texane/ooklone/doc/pic/scaled/0024.jpg

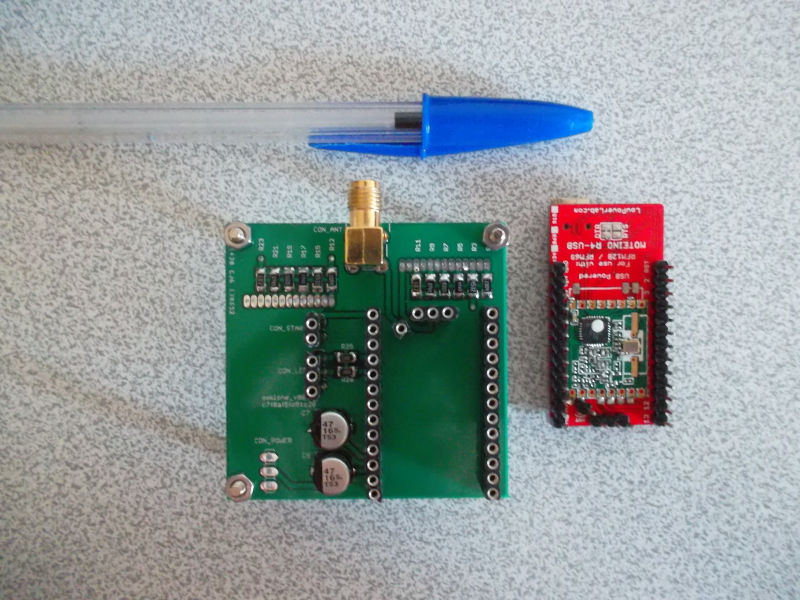
doc/pic/scaled/0024.jpg
