texane/ooklone/doc/pic/scaled/002f.jpg

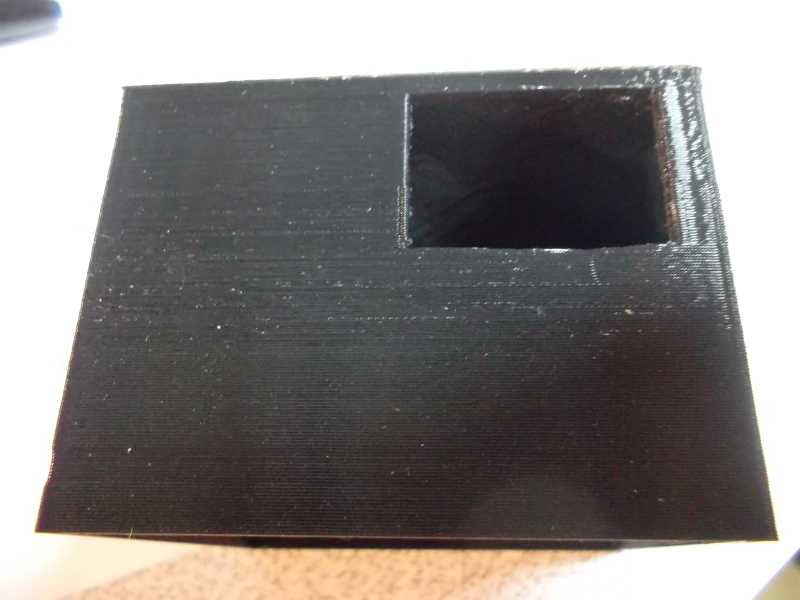
doc/pic/scaled/002f.jpg
