texane/ooklone/README

For more info, please read the article here:
http://www.embeddedrelated.com/showarticle/626.php
Also, this project was submitted to the Hackaday Prize Contest:
http://hackaday.io/project/2403-ooklone
