texane/ooklone/doc/pic/scaled/0000.jpg

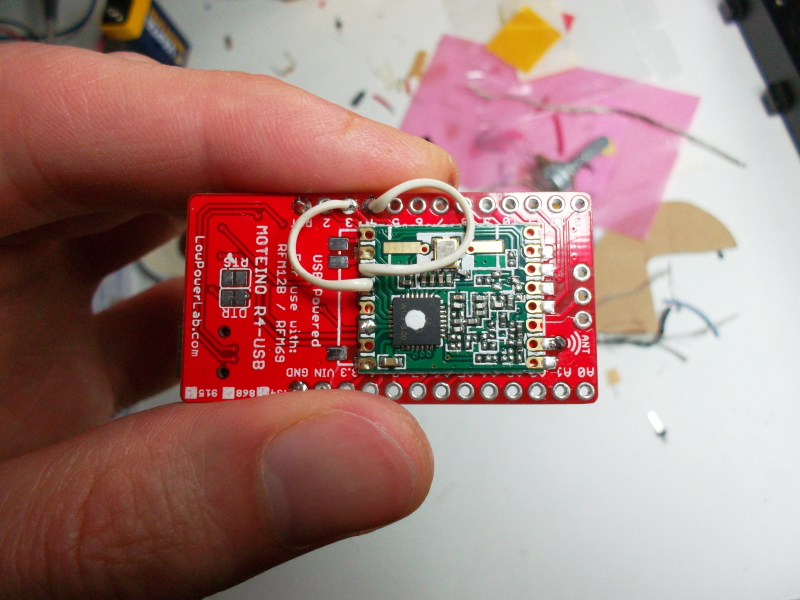
doc/pic/scaled/0000.jpg
