texane/ooklone/doc/pic/scaled/000a.jpg

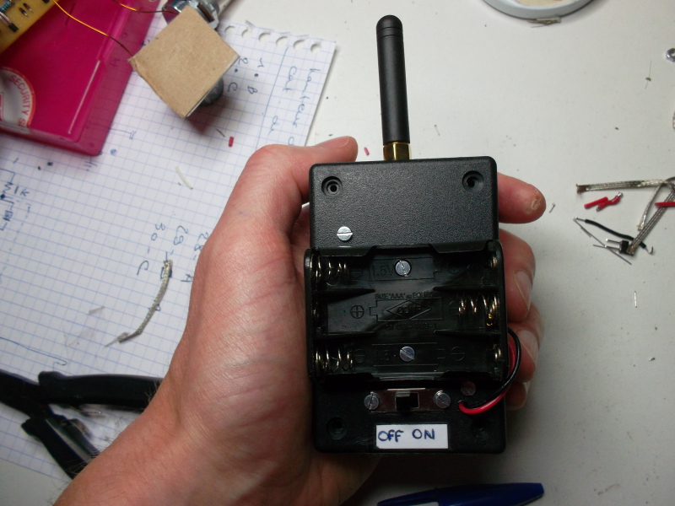
doc/pic/scaled/000a.jpg
