texane/ooklone/doc/pic/scaled/000b.jpg

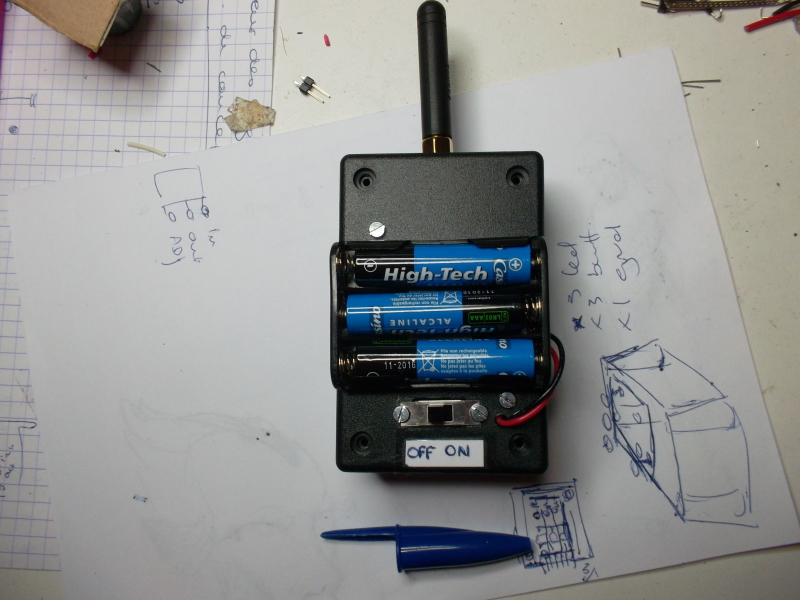
doc/pic/scaled/000b.jpg
