texane/ooklone/doc/pic/scaled/000c.jpg

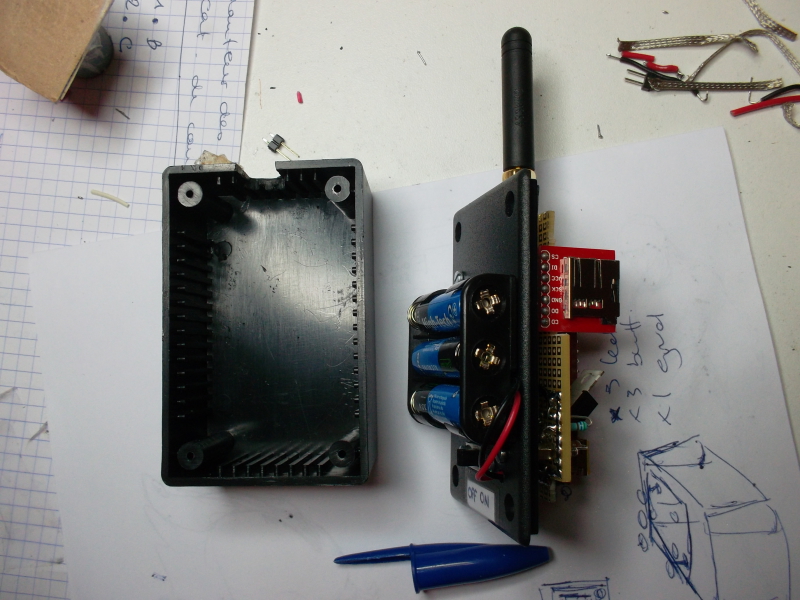
doc/pic/scaled/000c.jpg
