texane/ooklone/doc/pic/scaled/000d.jpg

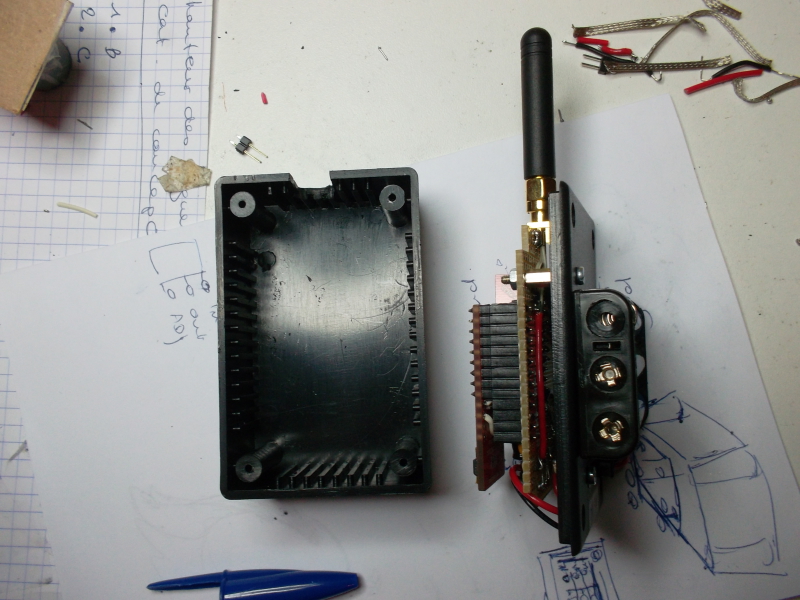
doc/pic/scaled/000d.jpg
