texane/ooklone/doc/pic/scaled/000e.jpg

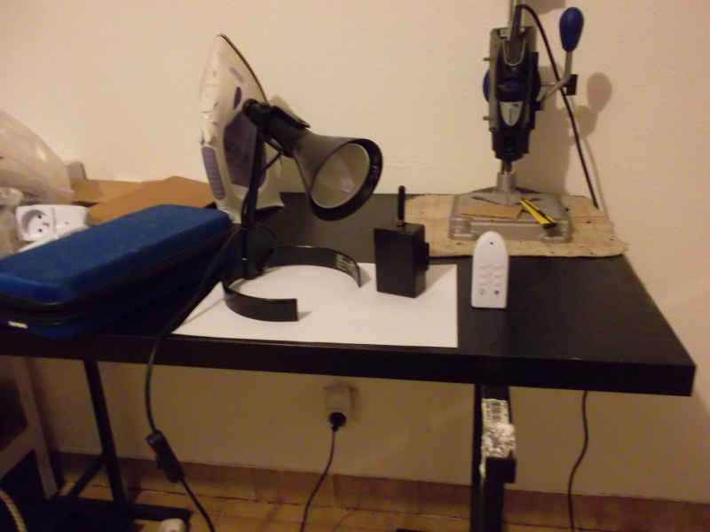
doc/pic/scaled/000e.jpg
