texane/ooklone/doc/pic/scaled/000f.jpg

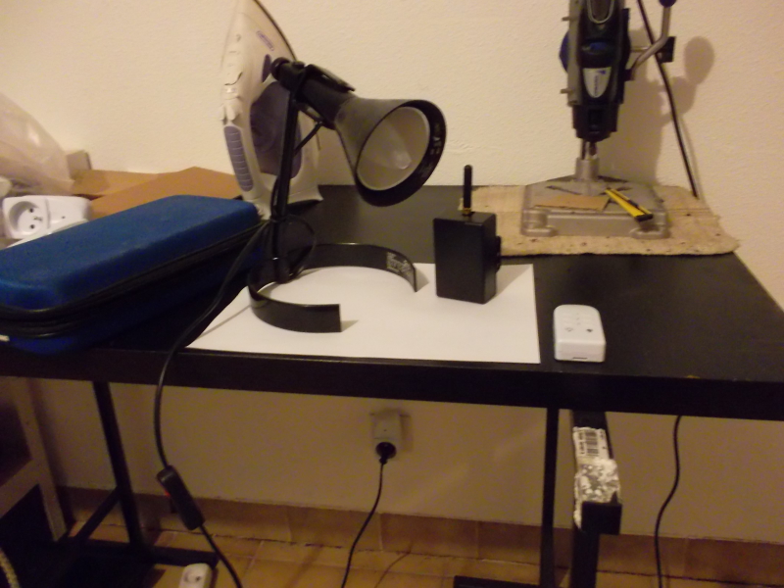
doc/pic/scaled/000f.jpg
