texane/ooklone/doc/pic/scaled/0001.jpg

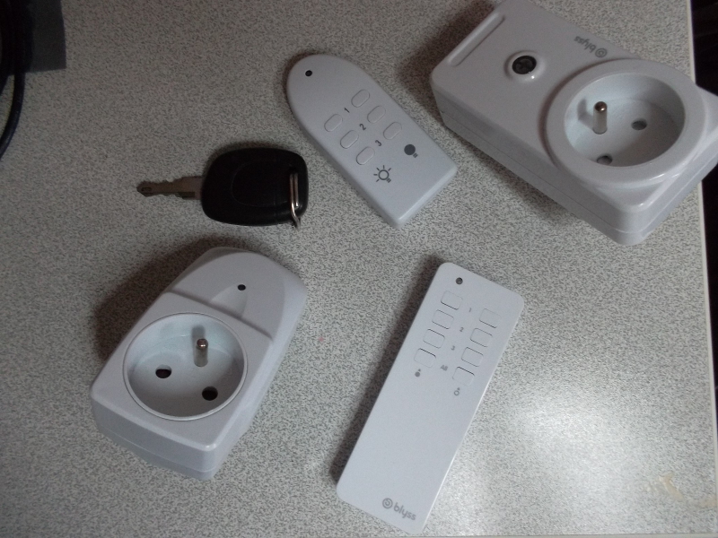
doc/pic/scaled/0001.jpg
