texane/ooklone/doc/pic/scaled/001a.jpg

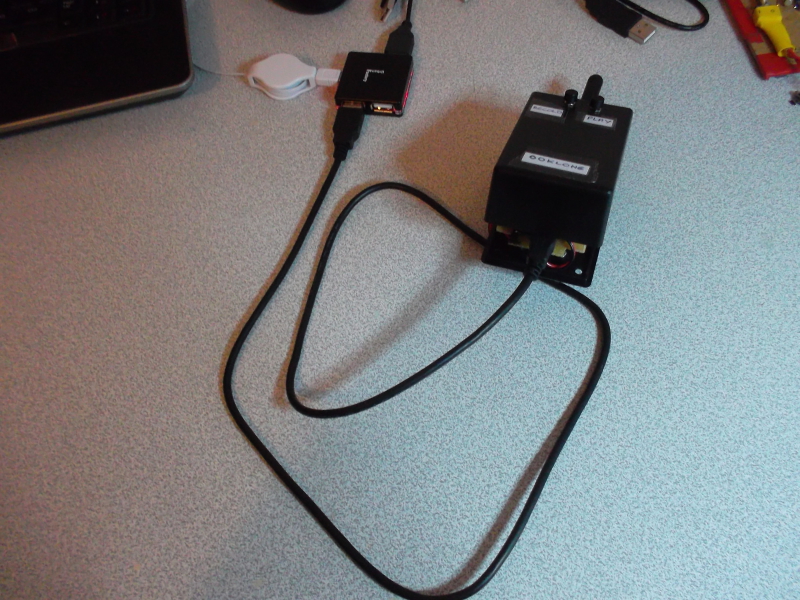
doc/pic/scaled/001a.jpg
