texane/ooklone/doc/pic/scaled/001b.jpg

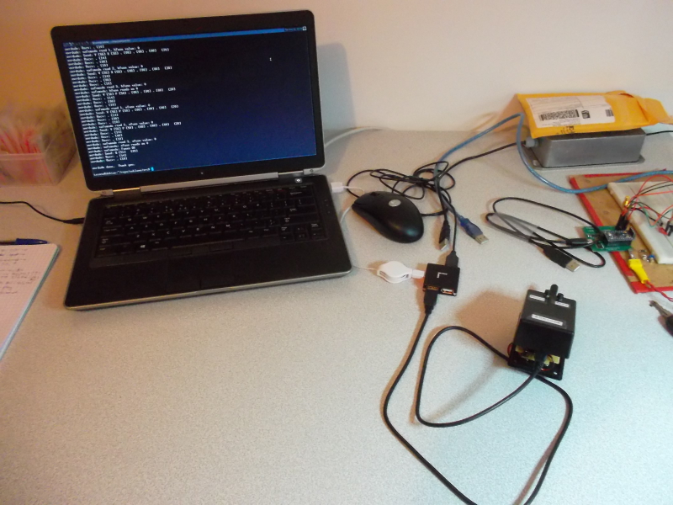
doc/pic/scaled/001b.jpg
