texane/ooklone/doc/pic/scaled/001c.jpg

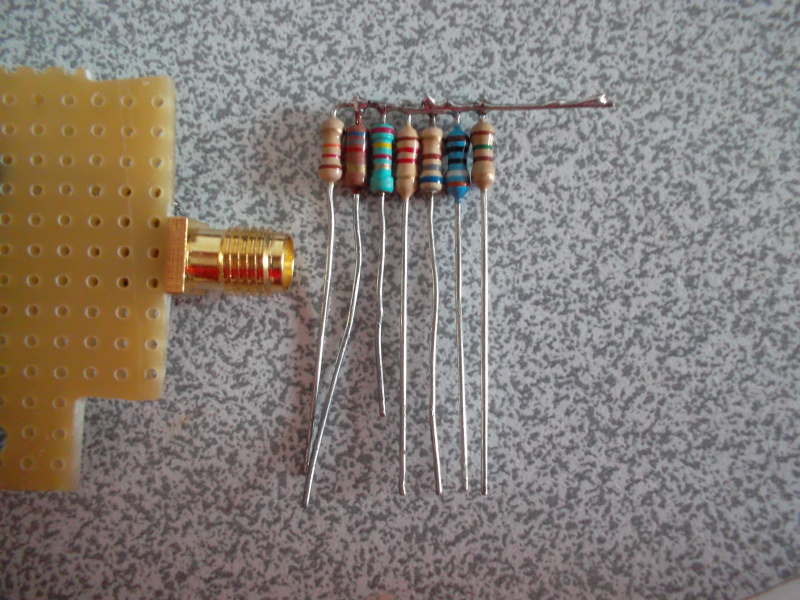
doc/pic/scaled/001c.jpg
