texane/ooklone/doc/pic/scaled/001d.jpg

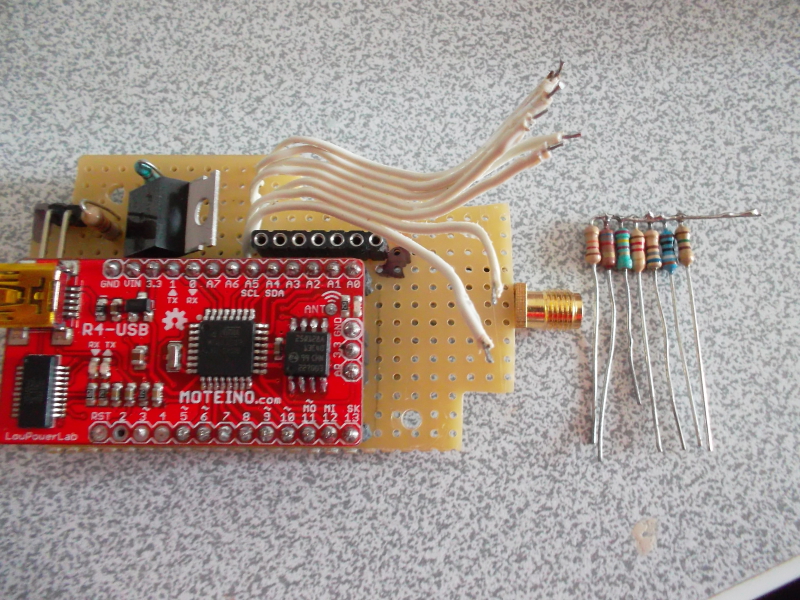
doc/pic/scaled/001d.jpg
