texane/ooklone/doc/pic/scaled/001e.jpg

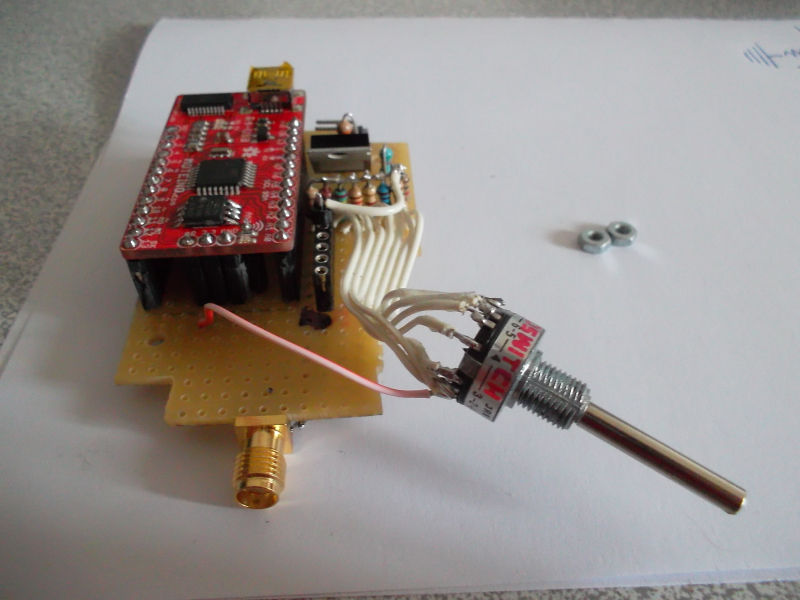
doc/pic/scaled/001e.jpg
