texane/ooklone/doc/pic/scaled/001f.jpg

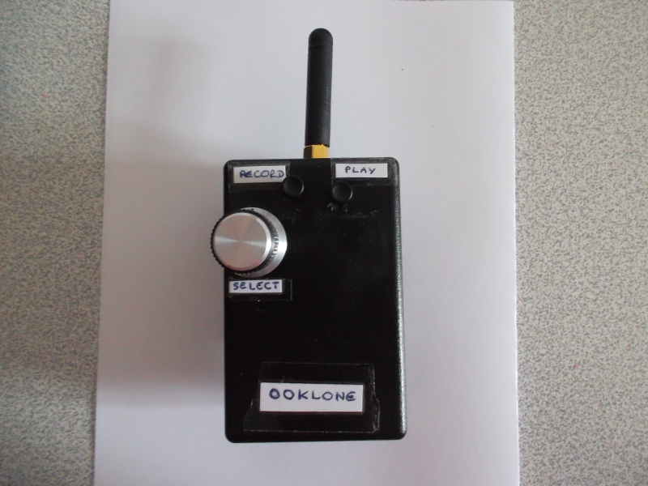
doc/pic/scaled/001f.jpg
