texane/ooklone/doc/pic/scaled/0002.jpg

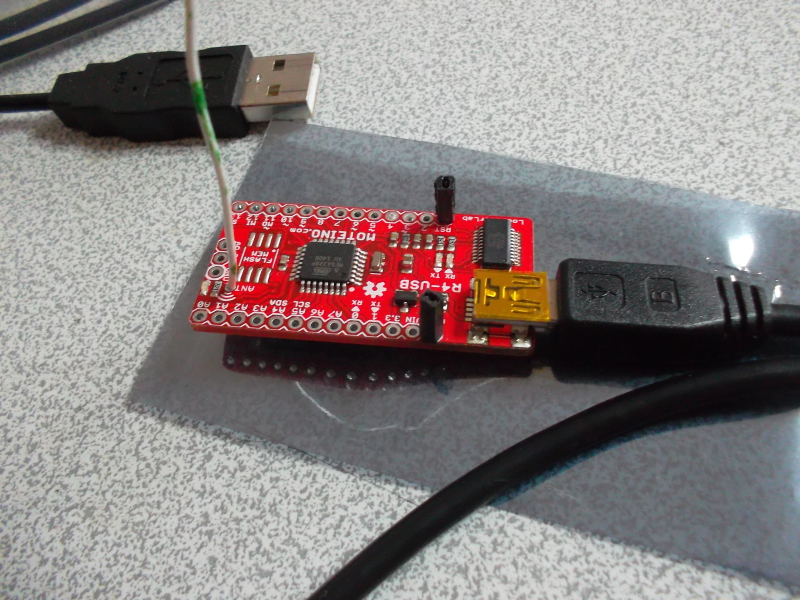
doc/pic/scaled/0002.jpg
