texane/ooklone/doc/pic/scaled/002a.jpg

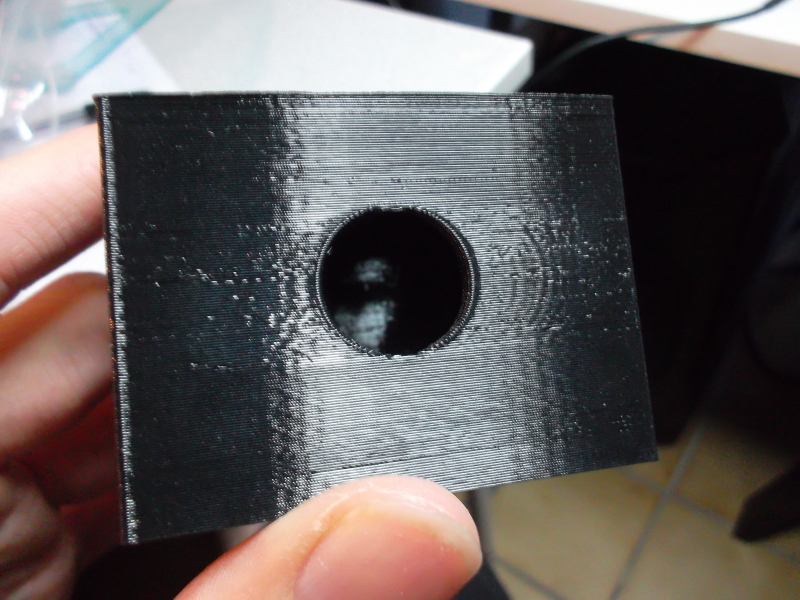
doc/pic/scaled/002a.jpg
