texane/ooklone/doc/pic/scaled/002b.jpg

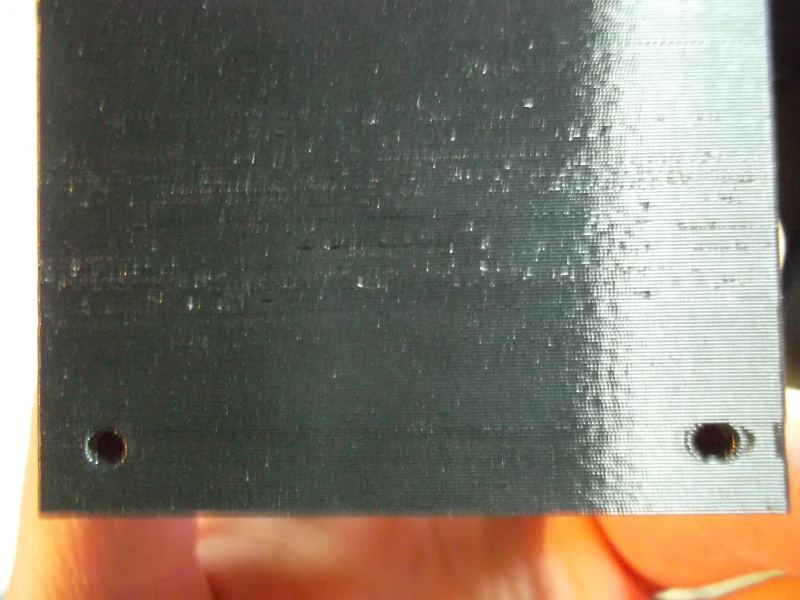
doc/pic/scaled/002b.jpg
