texane/ooklone/doc/pic/scaled/002c.jpg

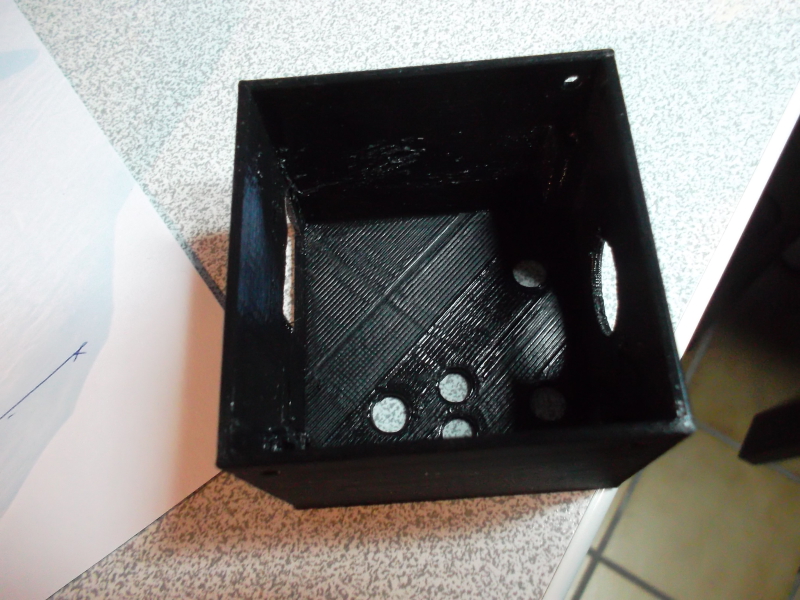
doc/pic/scaled/002c.jpg
