texane/ooklone/doc/pic/scaled/002d.jpg

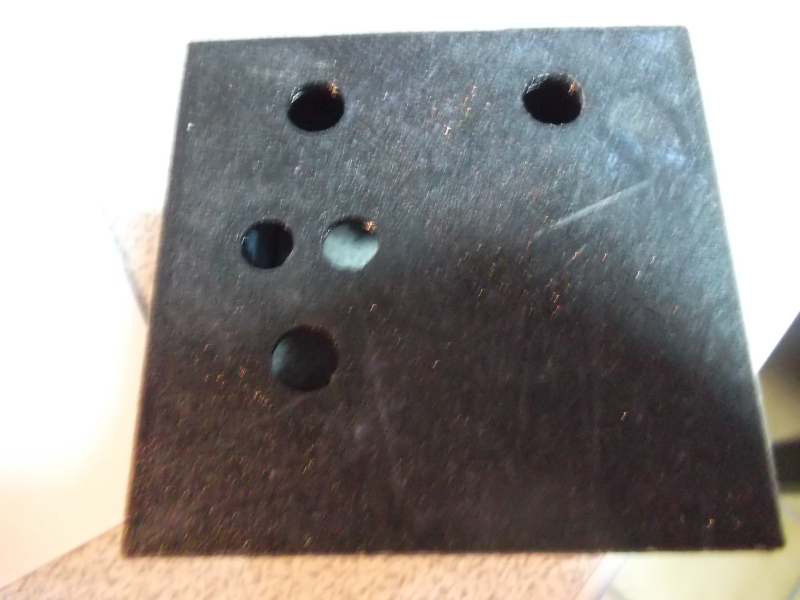
doc/pic/scaled/002d.jpg
