texane/ooklone/doc/pic/scaled/002e.jpg

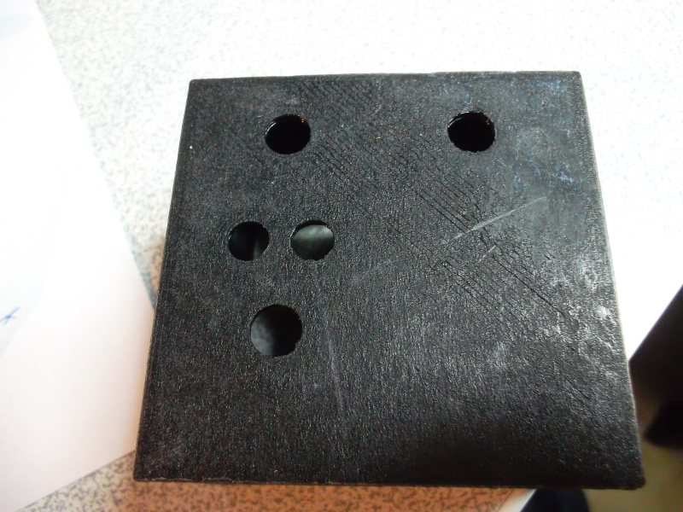
doc/pic/scaled/002e.jpg
