texane/ooklone/doc/pic/scaled/0003.jpg

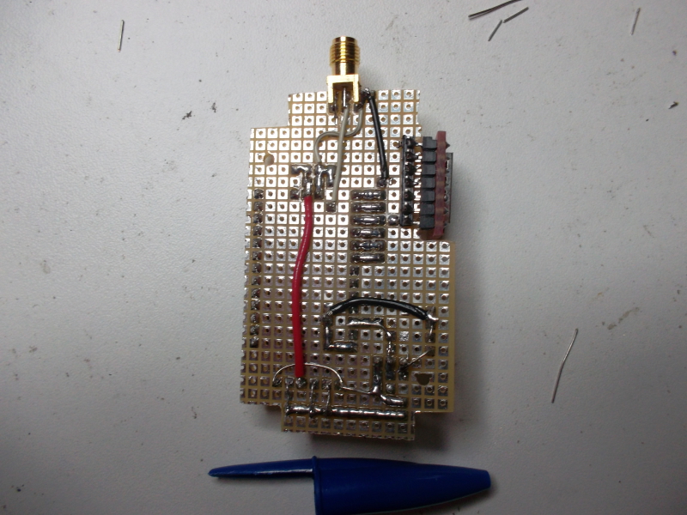
doc/pic/scaled/0003.jpg
