texane/ooklone/doc/pic/scaled/0004.jpg

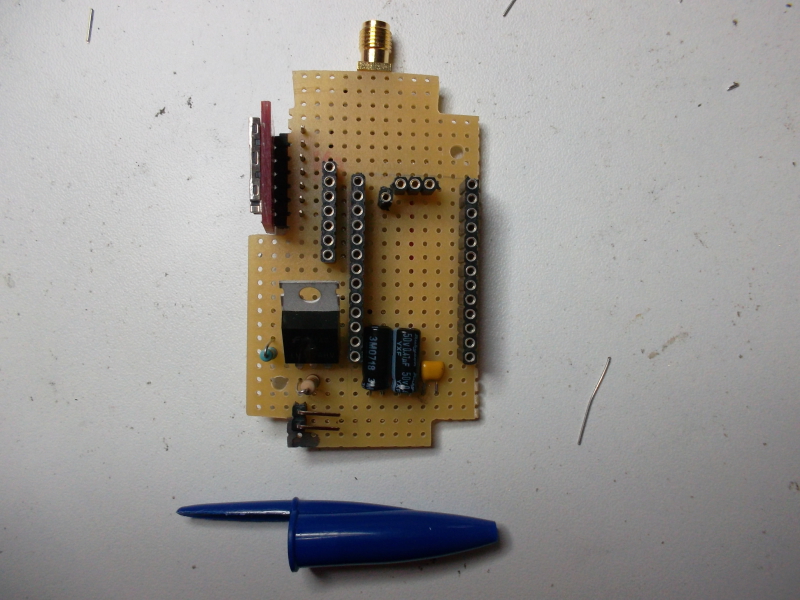
doc/pic/scaled/0004.jpg
