texane/ooklone/doc/pic/scaled/0005.jpg

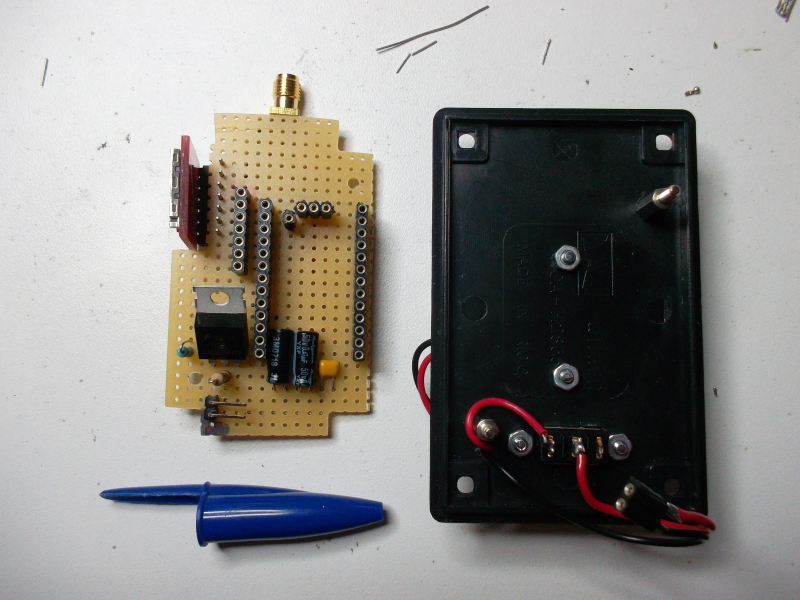
doc/pic/scaled/0005.jpg
