texane/ooklone/doc/pic/scaled/0006.jpg

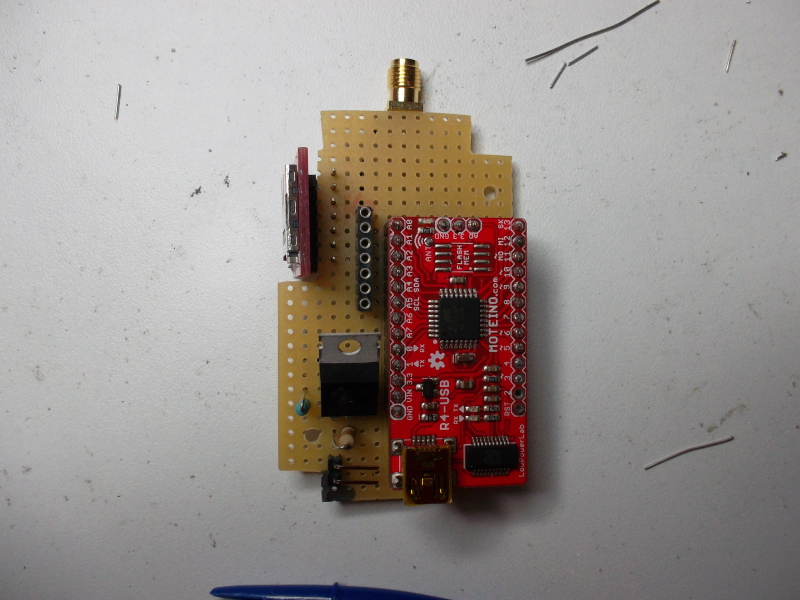
doc/pic/scaled/0006.jpg
