texane/ooklone/doc/pic/scaled/0007.jpg

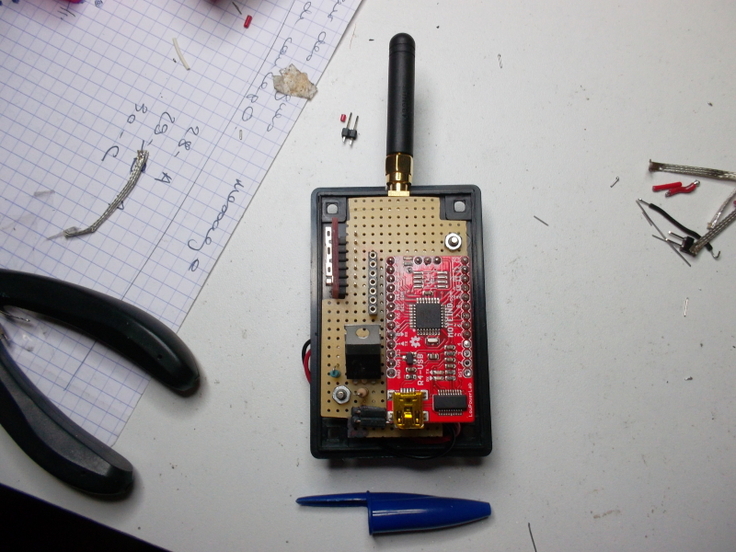
doc/pic/scaled/0007.jpg
