texane/ooklone/doc/pic/scaled/0008.jpg

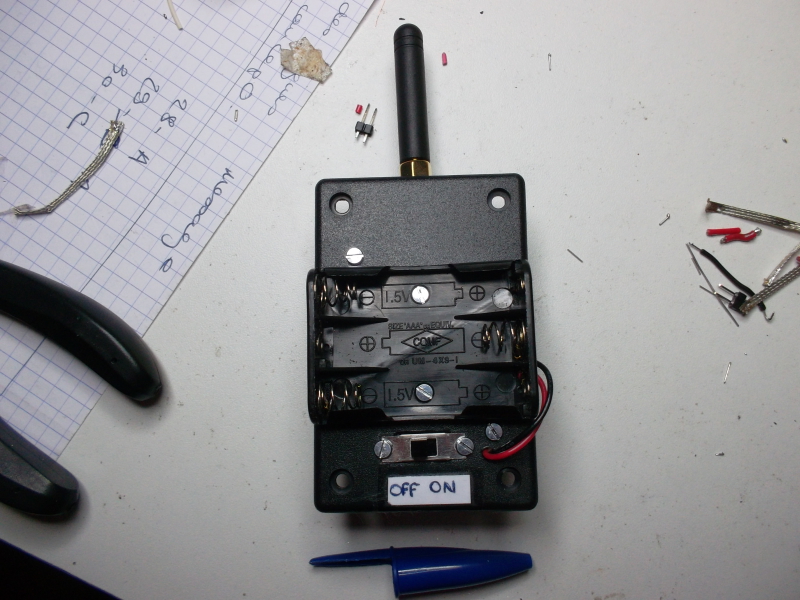
doc/pic/scaled/0008.jpg
