texane/ooklone/doc/pic/scaled/0009.jpg

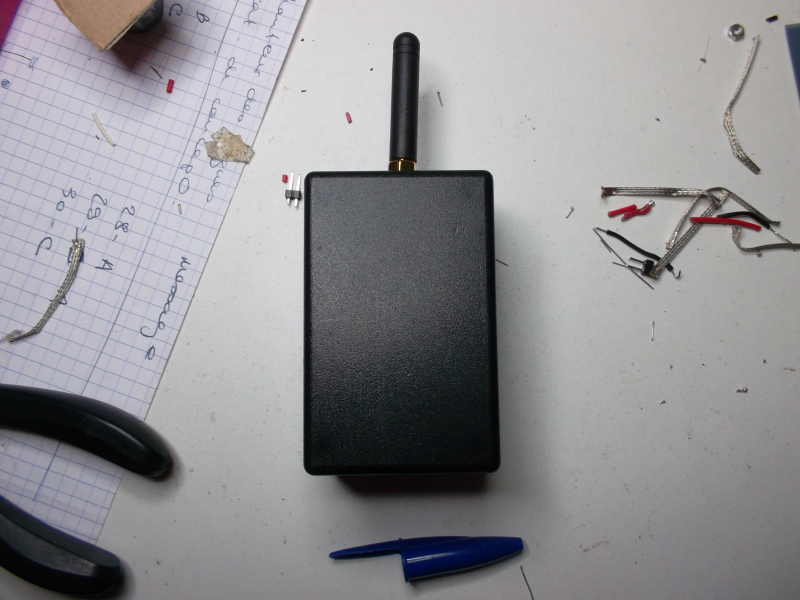
doc/pic/scaled/0009.jpg
