texane/ooklone/doc/pic/scaled/0010.jpg

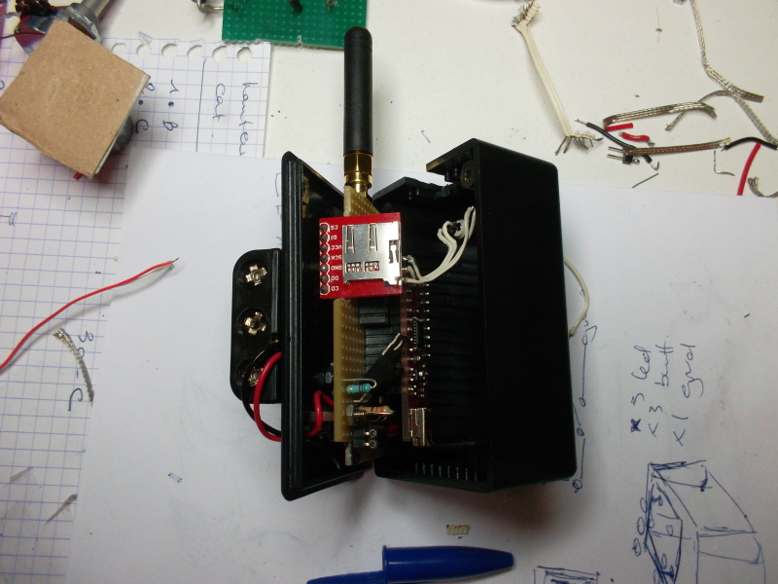
doc/pic/scaled/0010.jpg
