texane/ooklone/doc/pic/scaled/0011.jpg

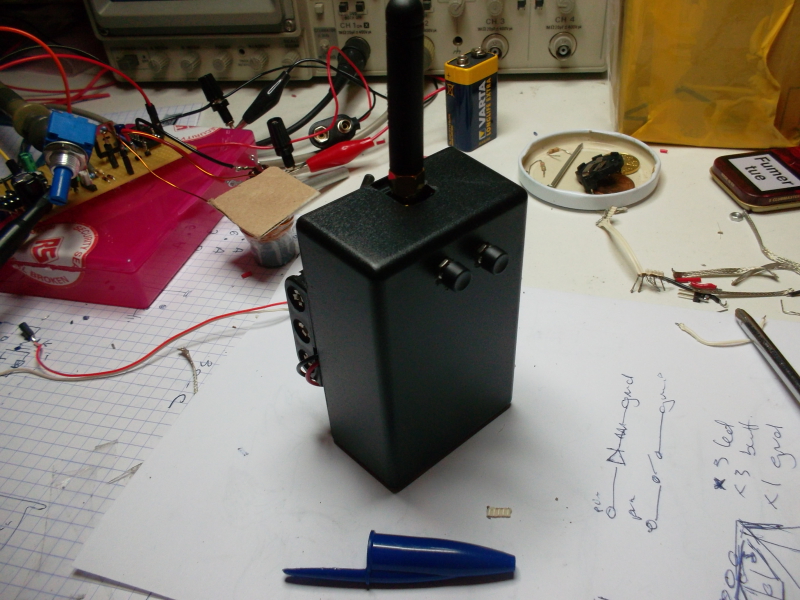
doc/pic/scaled/0011.jpg
