texane/ooklone/doc/pic/scaled/0012.jpg

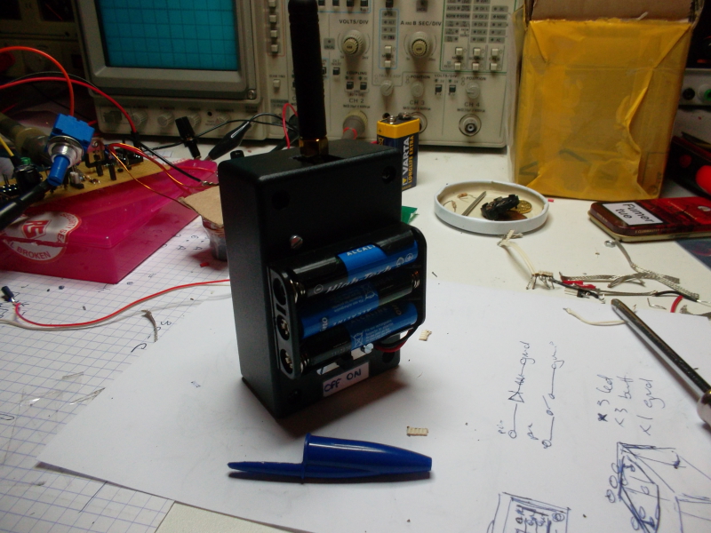
doc/pic/scaled/0012.jpg
