texane/ooklone/doc/pic/scaled/0013.jpg

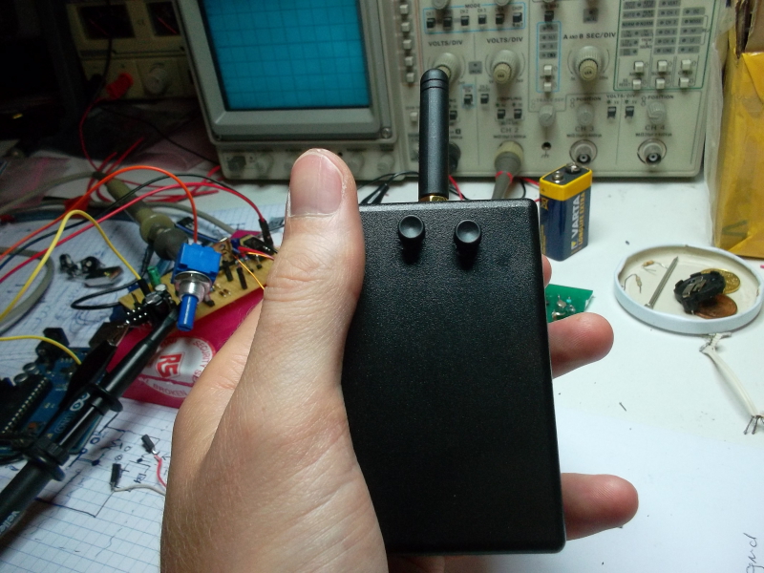
doc/pic/scaled/0013.jpg
