texane/ooklone/doc/pic/scaled/0014.jpg

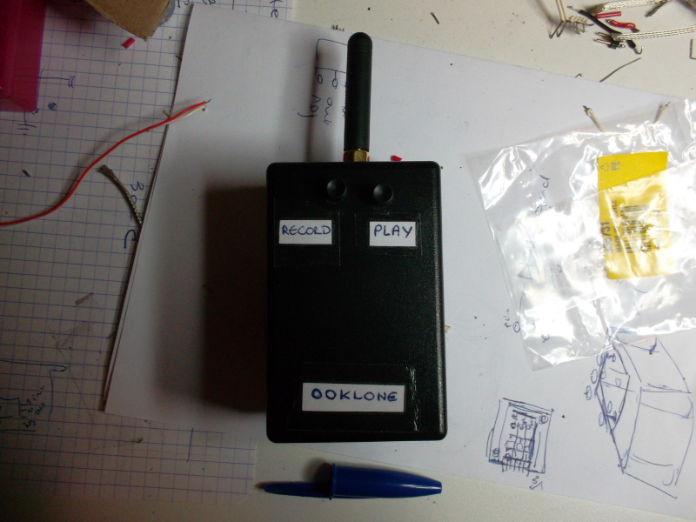
doc/pic/scaled/0014.jpg
