texane/ooklone/doc/pic/scaled/0015.jpg

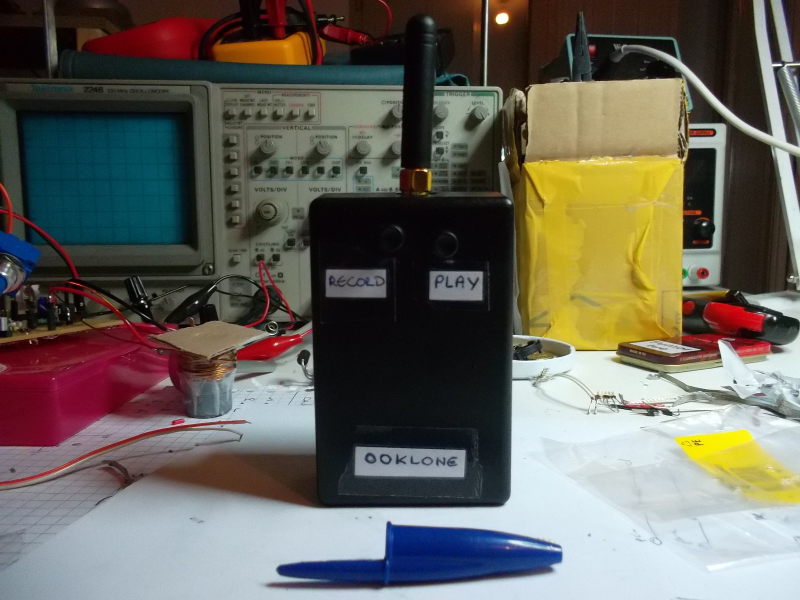
doc/pic/scaled/0015.jpg
