texane/ooklone/doc/pic/scaled/0016.jpg

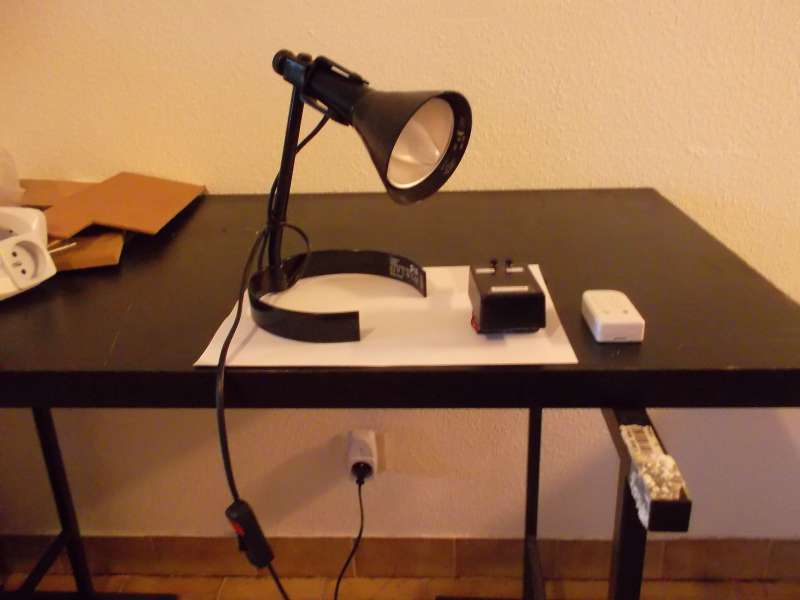
doc/pic/scaled/0016.jpg
