texane/ooklone/doc/pic/scaled/0017.jpg

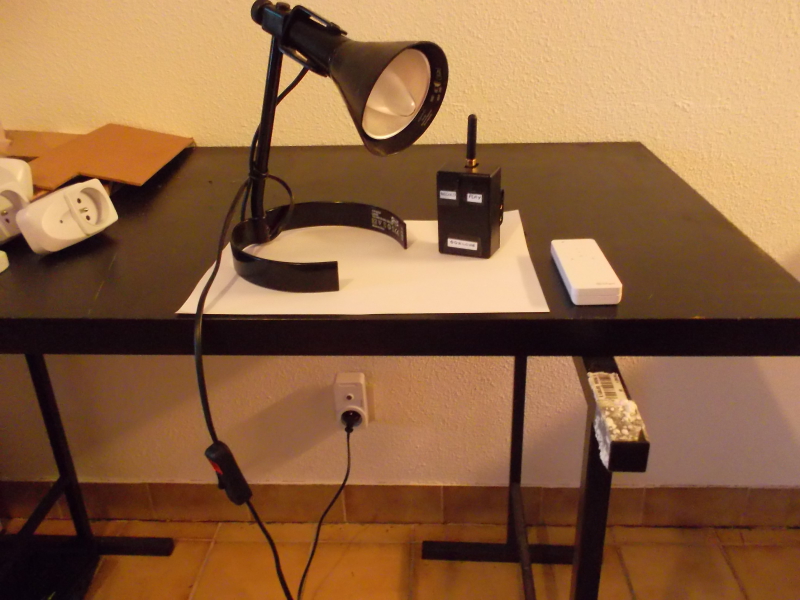
doc/pic/scaled/0017.jpg
