texane/ooklone/doc/pic/scaled/0018.jpg

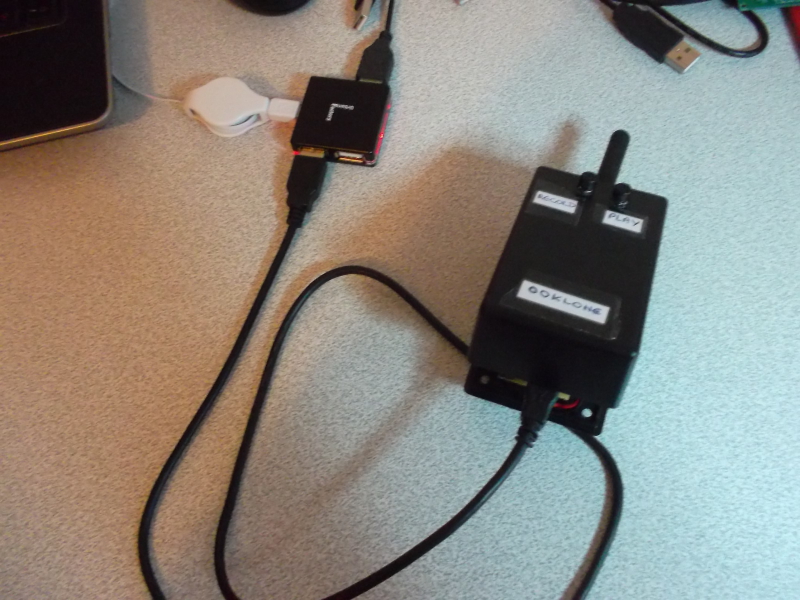
doc/pic/scaled/0018.jpg
