texane/ooklone/doc/pic/scaled/0019.jpg

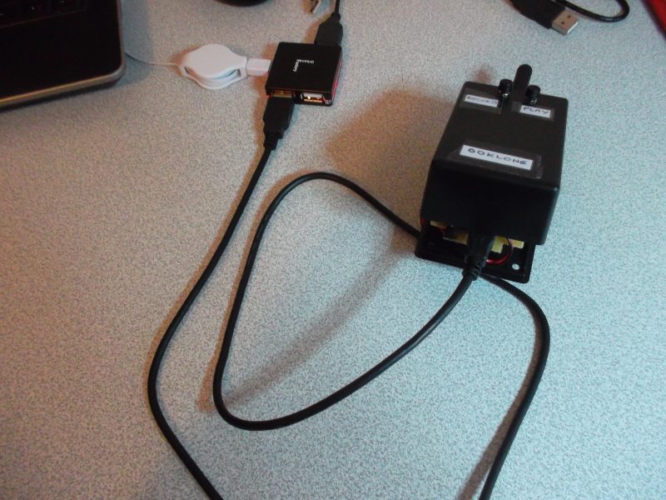
doc/pic/scaled/0019.jpg
