texane/ooklone/doc/pic/scaled/0020.jpg

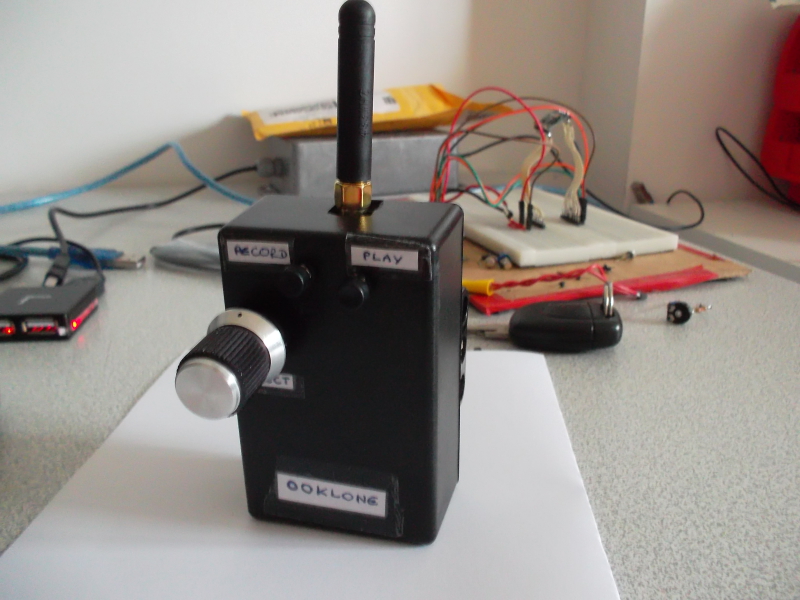
doc/pic/scaled/0020.jpg
