texane/ooklone/doc/pic/scaled/0021.jpg

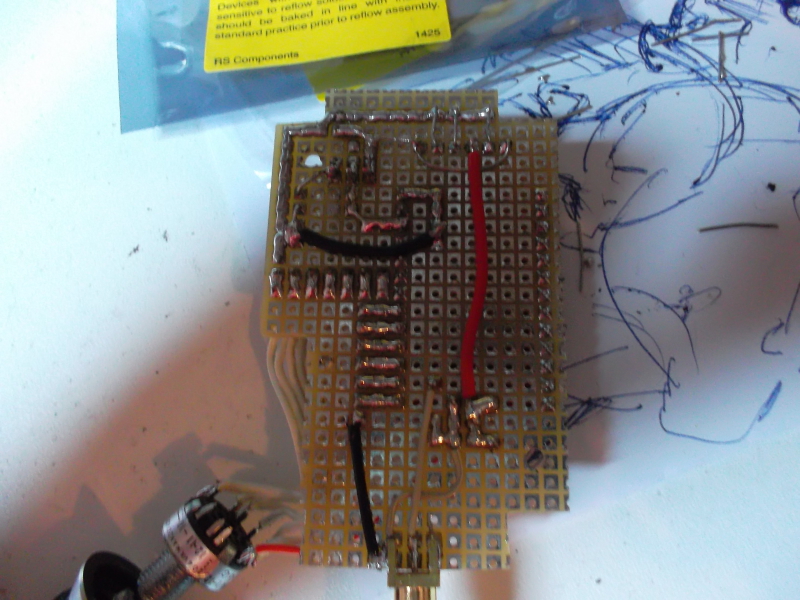
doc/pic/scaled/0021.jpg
