texane/ooklone/doc/pic/scaled/0022.jpg

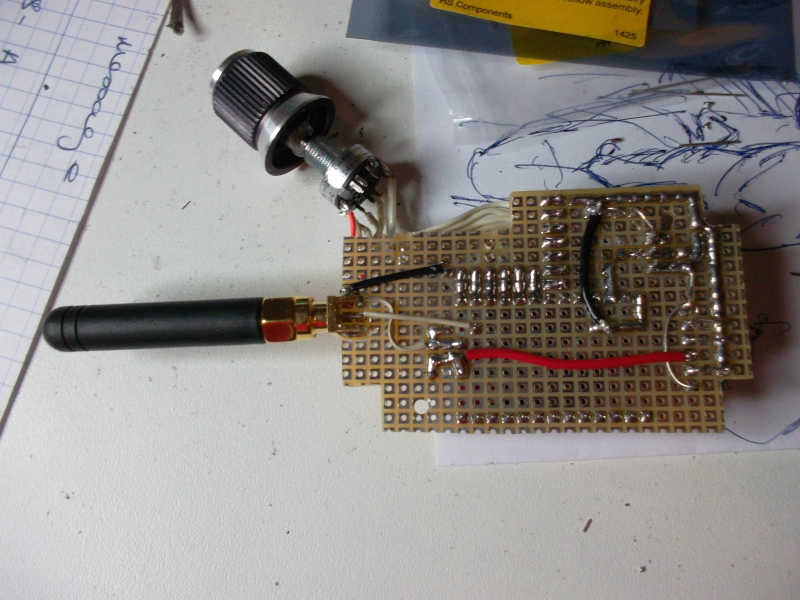
doc/pic/scaled/0022.jpg
