texane/ooklone/doc/pic/scaled/0023.jpg

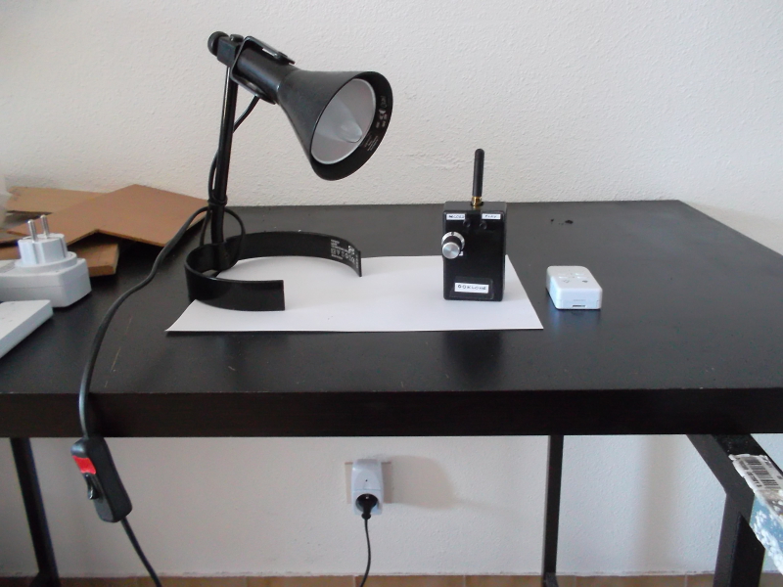
doc/pic/scaled/0023.jpg
