texane/ooklone/doc/pic/scaled/0025.jpg

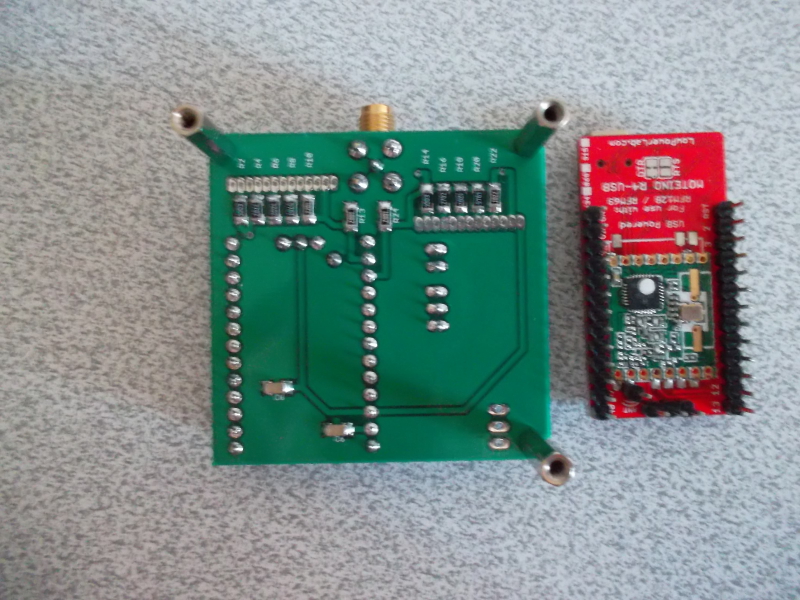
doc/pic/scaled/0025.jpg
