texane/ooklone/doc/pic/scaled/0026.jpg

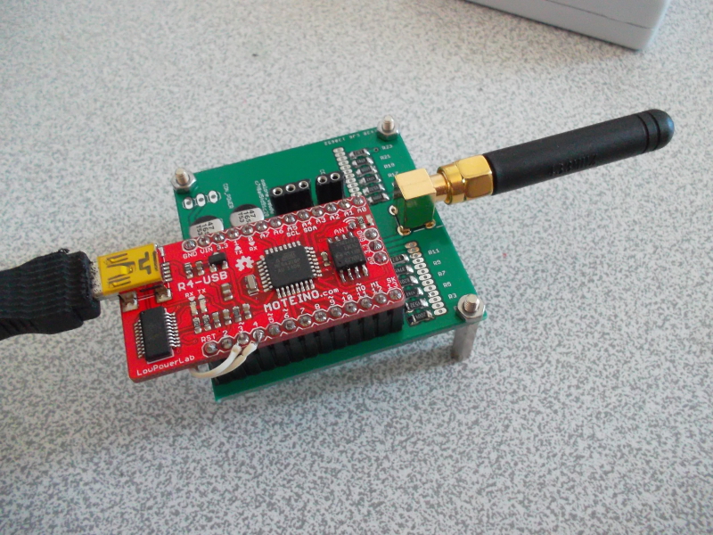
doc/pic/scaled/0026.jpg
