texane/ooklone/doc/pic/scaled/0027.jpg

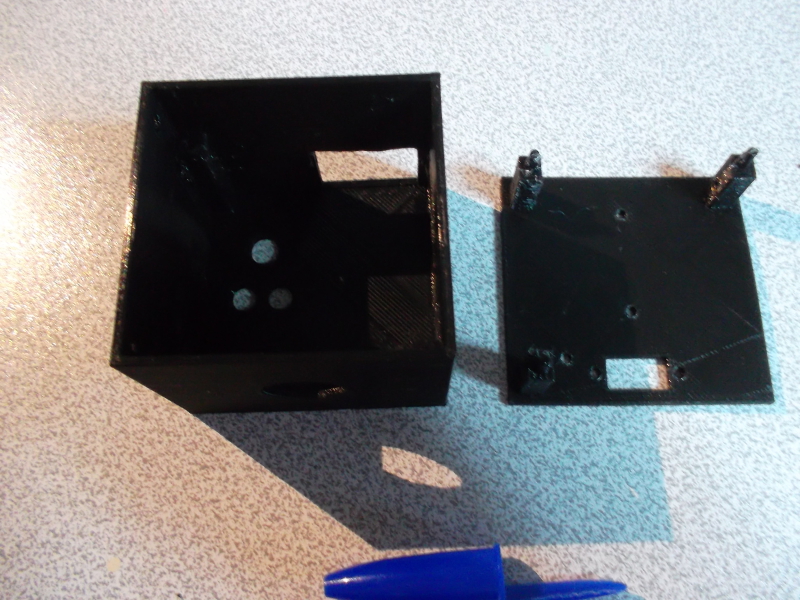
doc/pic/scaled/0027.jpg
