texane/ooklone/doc/pic/scaled/0028.jpg

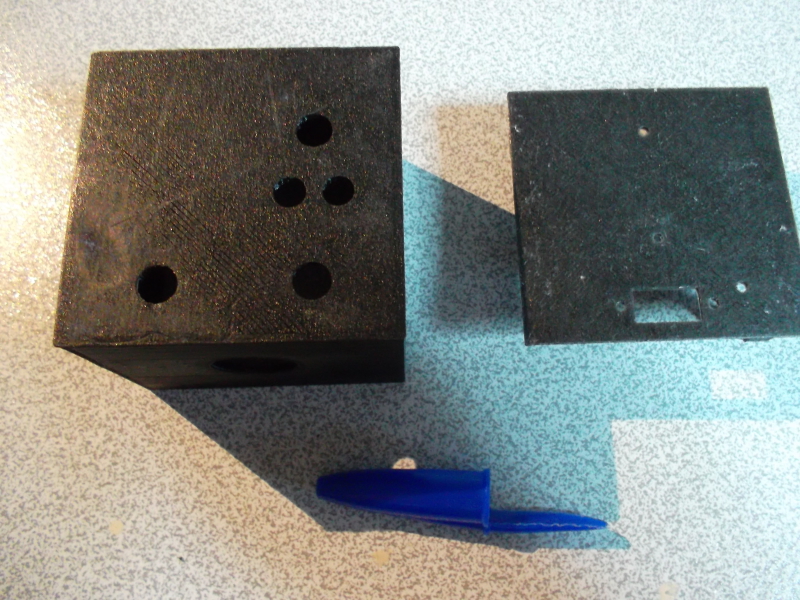
doc/pic/scaled/0028.jpg
