texane/ooklone/doc/pic/scaled/0029.jpg

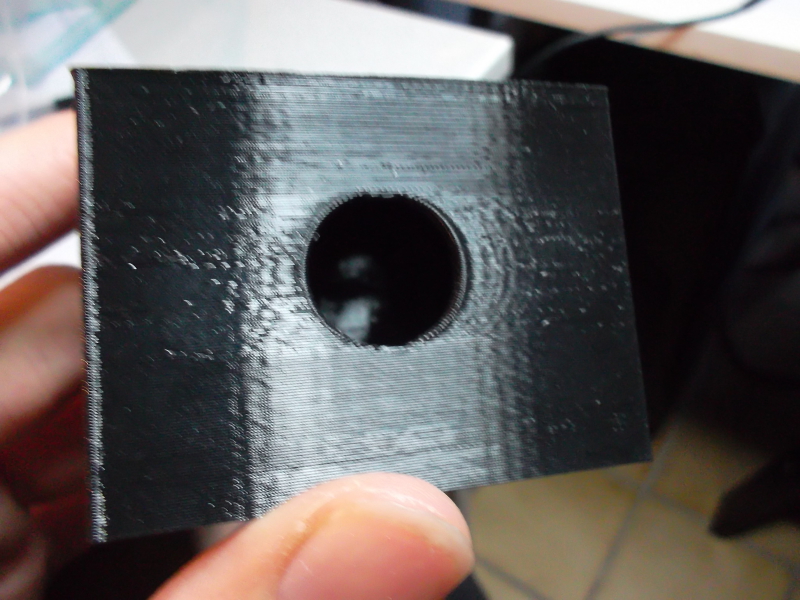
doc/pic/scaled/0029.jpg
