texane/ooklone/doc/pic/scaled/0030.jpg

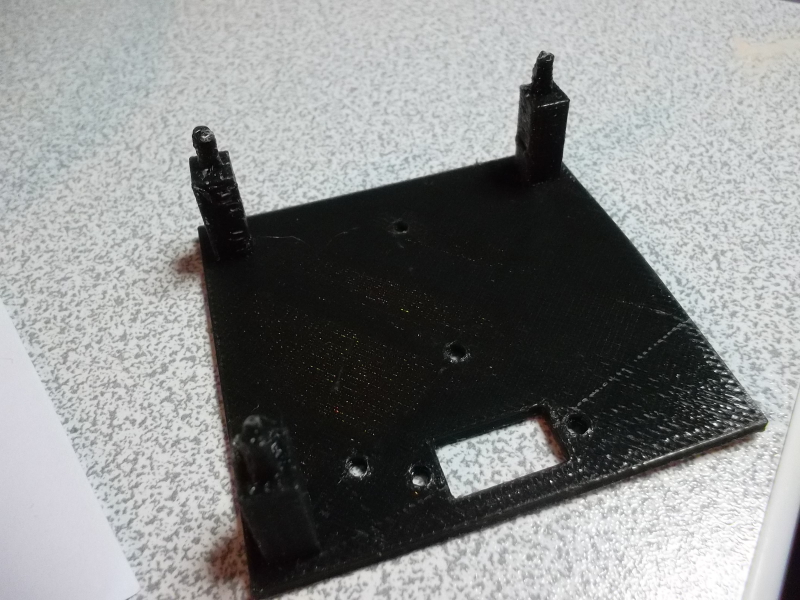
doc/pic/scaled/0030.jpg
