texane/ooklone/doc/pic/scaled/0031.jpg

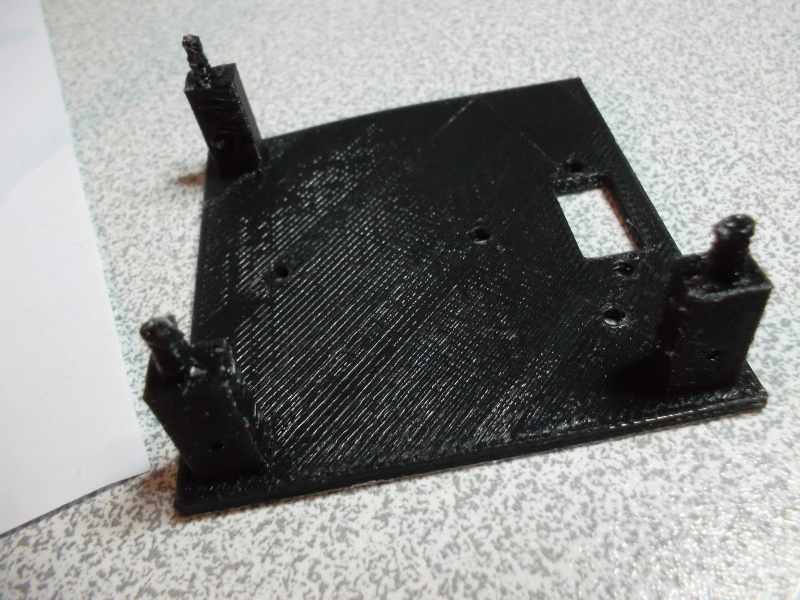
doc/pic/scaled/0031.jpg
