texane/ooklone/doc/pic/scaled/0032.jpg

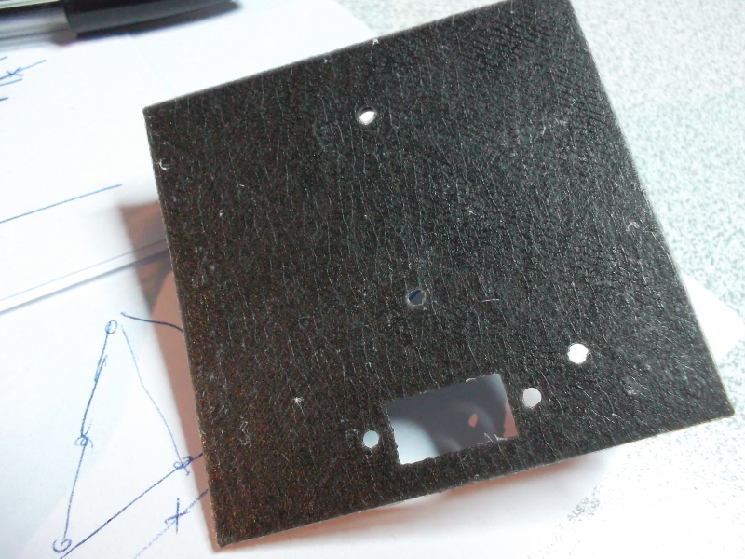
doc/pic/scaled/0032.jpg
