texane/ooklone/doc/system_design/main.png

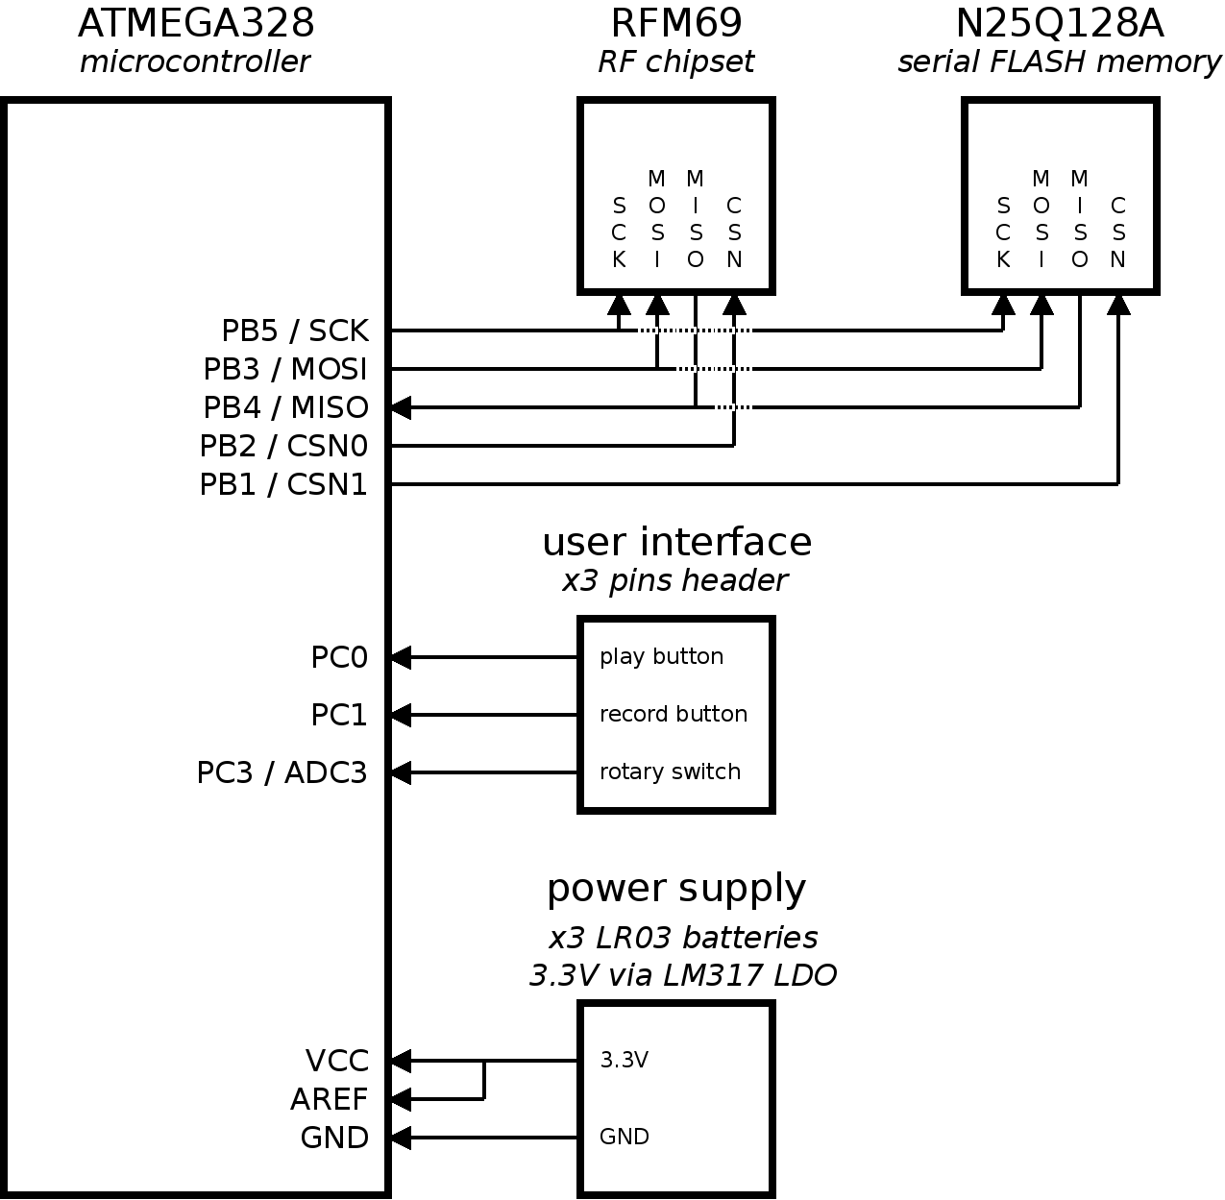
doc/system_design/main.png
