texane/ooklone/doc/user_interface/main.png

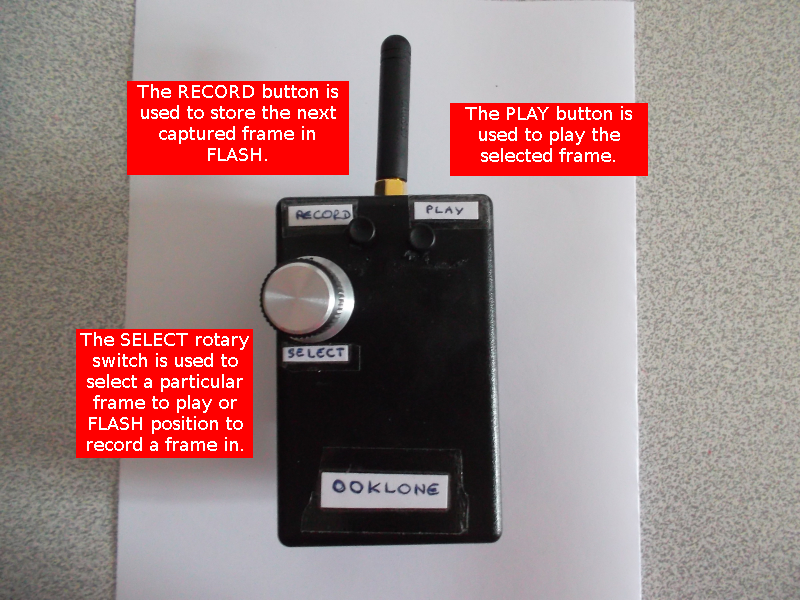
doc/user_interface/main.png
