texane/ooklone/solidworks/all/all.PNG

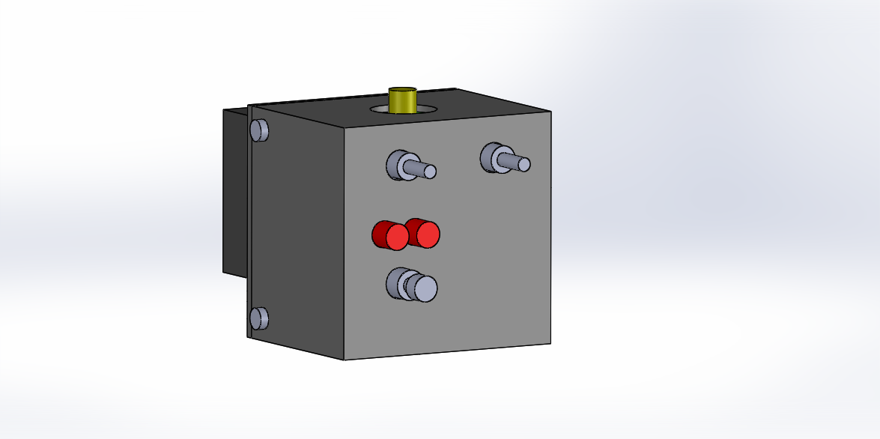
solidworks/all/all.PNG
