texane/ooklone/solidworks/board/board.SLDASM

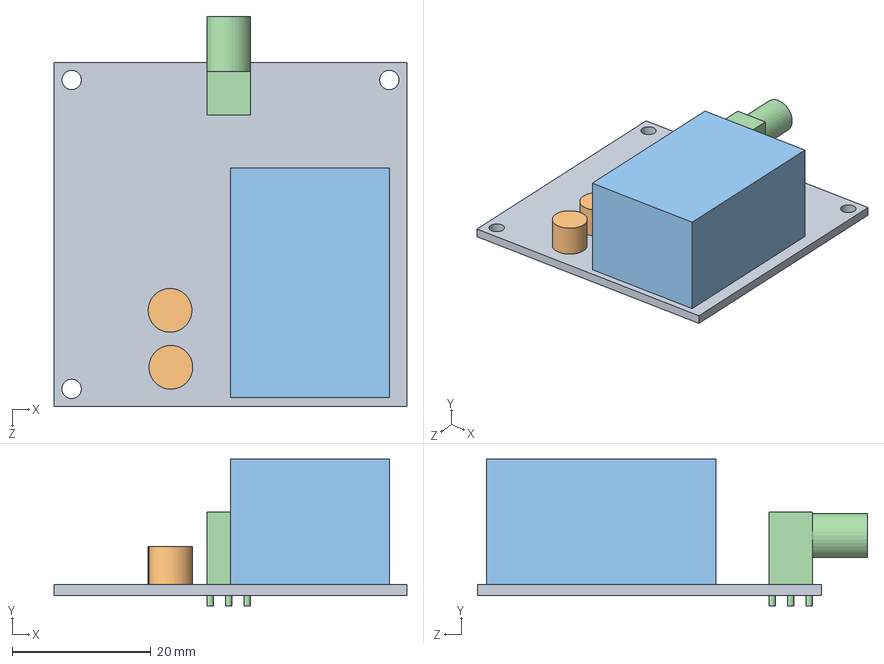
[picture p55: CAD file, 2014-09-16]
solidworks/board/board.SLDASM
50.8 x 21.1 x 56.1 mm
pcb
cap x 2
moteino
sma
