texane/ooklone/solidworks/box/back_inches.STL

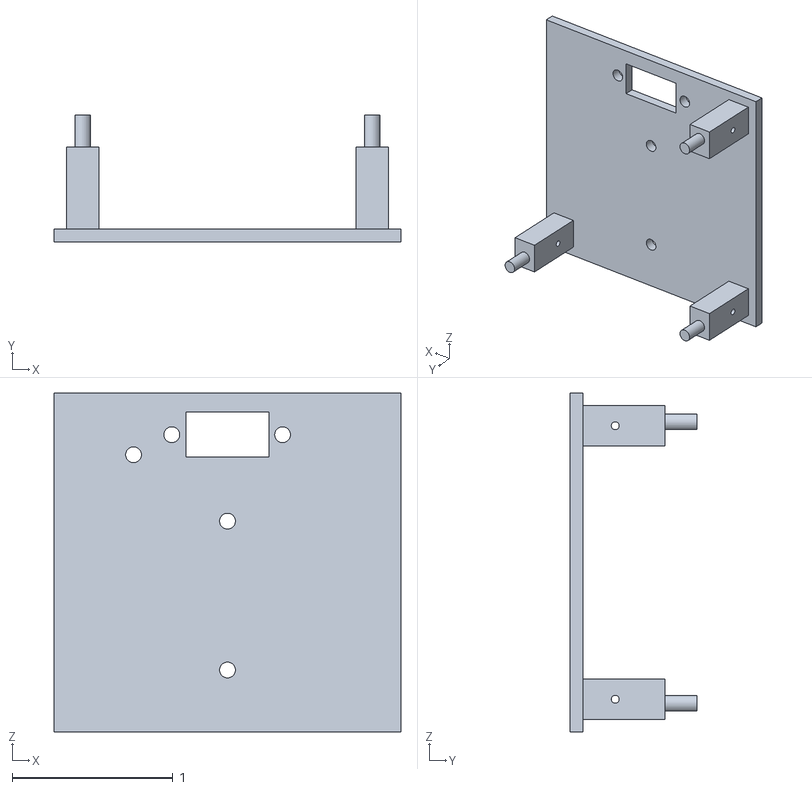
[picture p56: CAD file, 2014-09-22]
solidworks/box/back_inches.STL
2.16 x 0.787 x 2.11
