texane/ooklone/solidworks/misc/battery_holder.SLDPRT

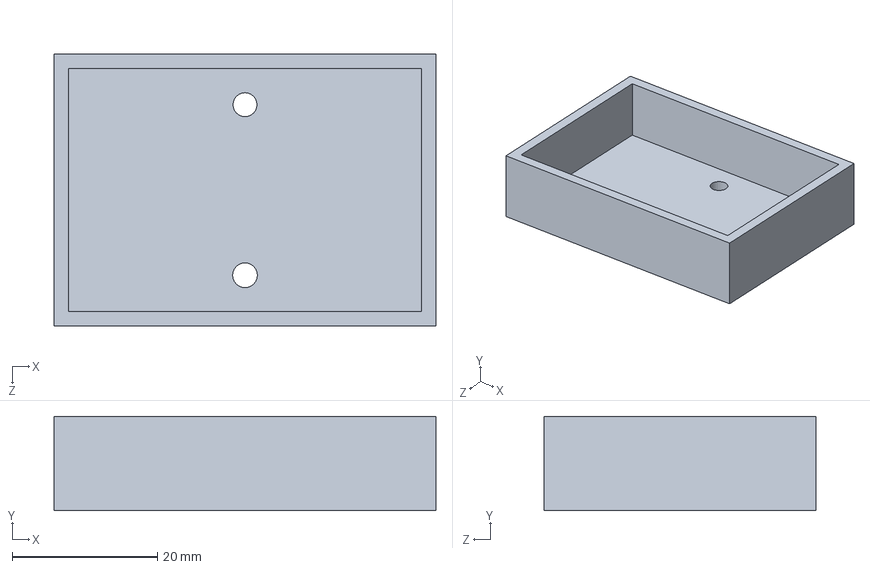
[picture p57: CAD file, 2014-09-21]
solidworks/misc/battery_holder.SLDPRT
52.6 x 13.0 x 37.5 mm
