texane/ooklone/solidworks/board/cap.SLDPRT

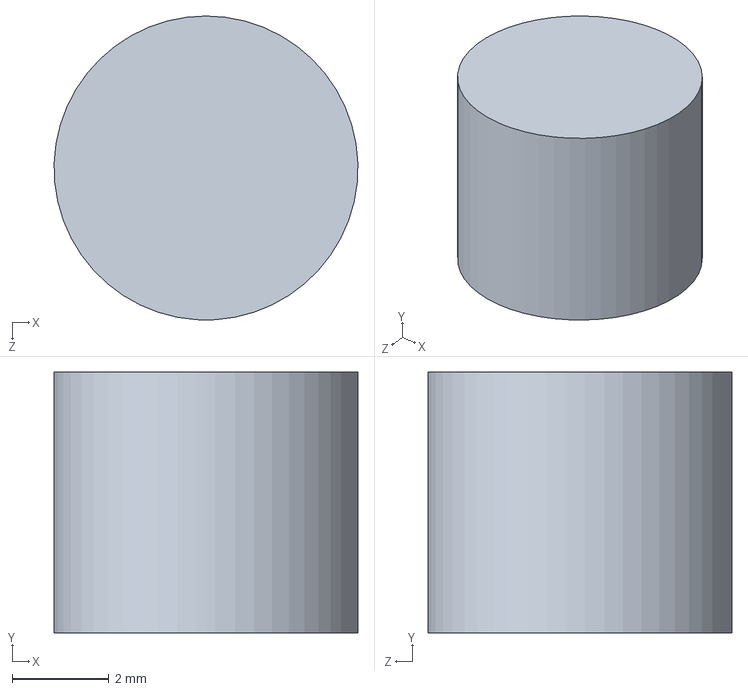
[picture p58: CAD file, 2014-09-15]
solidworks/board/cap.SLDPRT
6.30 x 5.40 x 6.30 mm
