texane/ooklone/solidworks/box/front_inches.STL

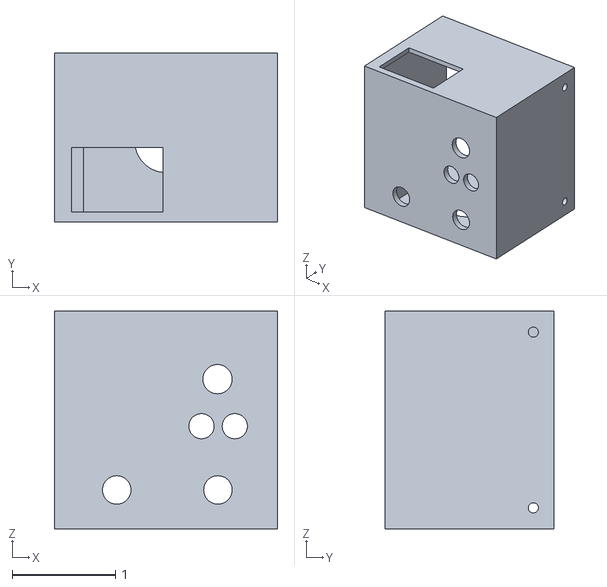
[picture p59: CAD file, 2014-09-22]
solidworks/box/front_inches.STL
2.16 x 1.64 x 2.11
