texane/ooklone/solidworks/misc/56SD30-01-1-AJN.SLDPRT

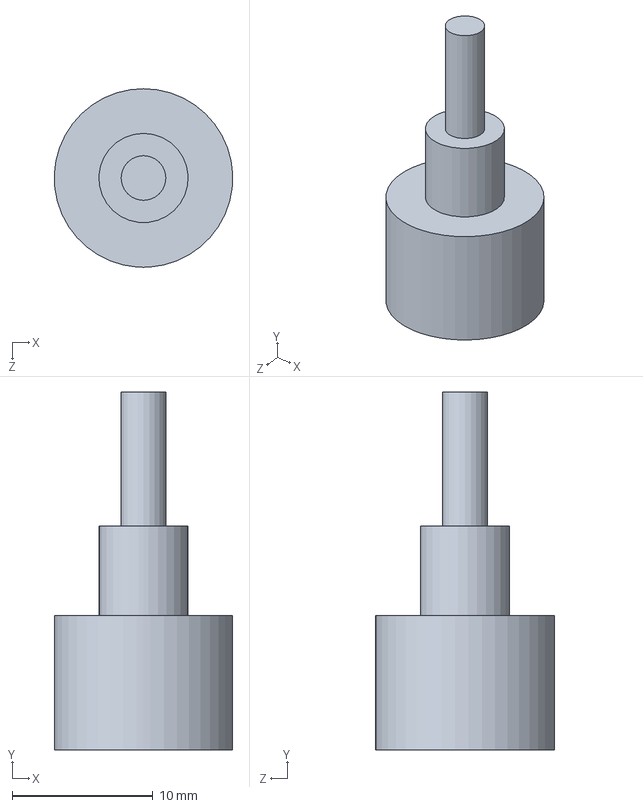
[picture p60: CAD file, 2014-09-19]
solidworks/misc/56SD30-01-1-AJN.SLDPRT
12.7 x 25.5 x 12.7 mm
