texane/ooklone/solidworks/board/moteino.SLDPRT

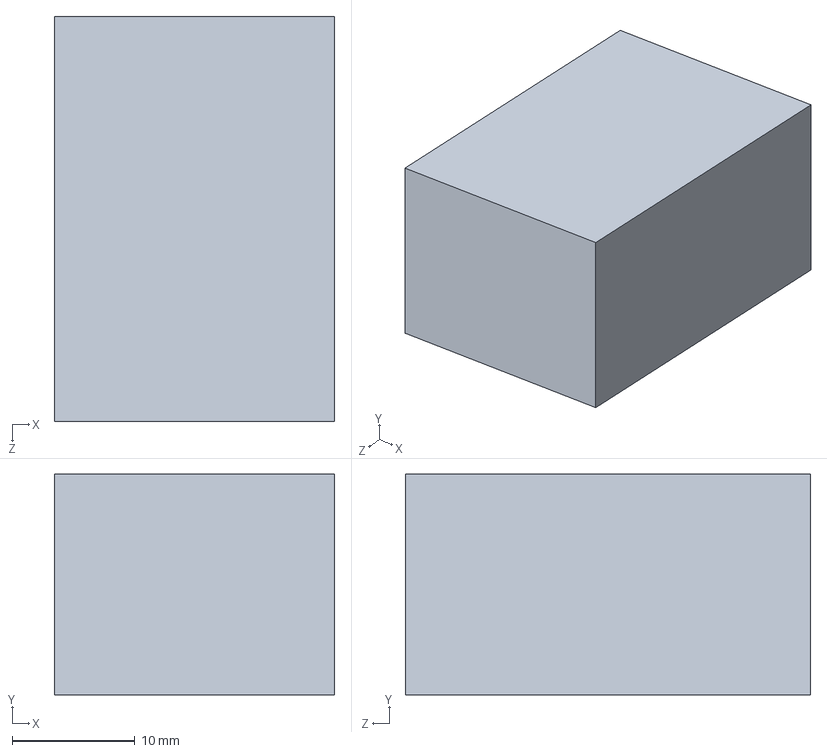
[picture p61: CAD file, 2014-09-15]
solidworks/board/moteino.SLDPRT
22.9 x 18.0 x 33.0 mm
