texane/ooklone/solidworks/box/front.SLDPRT

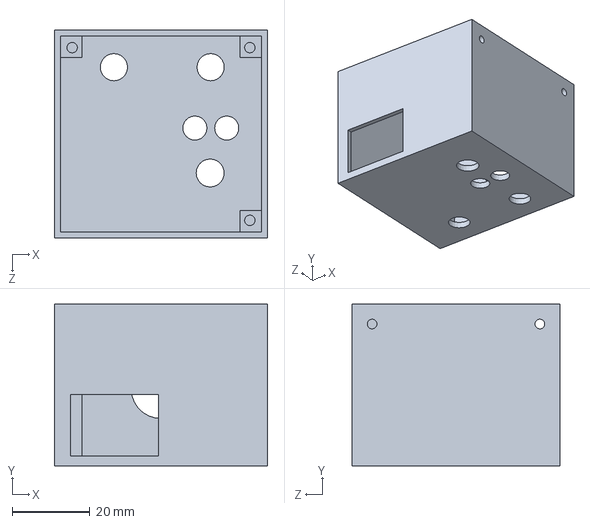
[picture p62: CAD file, 2014-09-21]
solidworks/box/front.SLDPRT
54.8 x 41.6 x 53.5 mm
