texane/ooklone/solidworks/board/pcb.SLDPRT

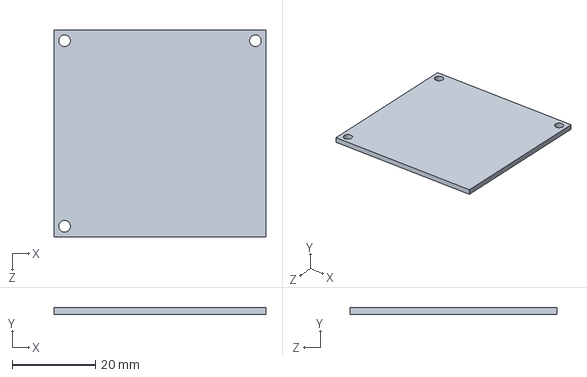
[picture p63: CAD file, 2014-09-15]
solidworks/board/pcb.SLDPRT
50.8 x 1.60 x 49.5 mm
