texane/ooklone/solidworks/box/back.SLDPRT

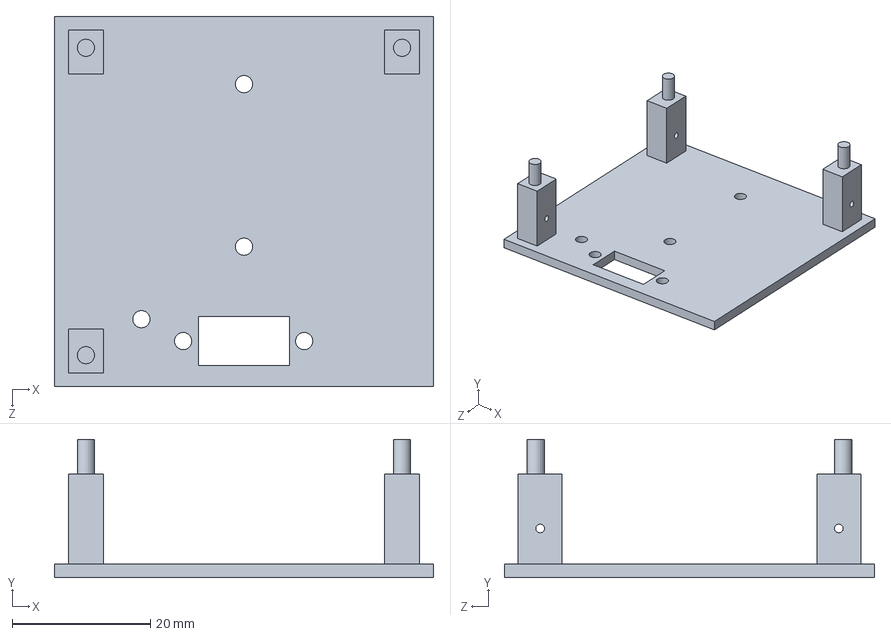
[picture p64: CAD file, 2014-09-21]
solidworks/box/back.SLDPRT
54.8 x 20.0 x 53.5 mm
