texane/ooklone/solidworks/misc/led.SLDPRT

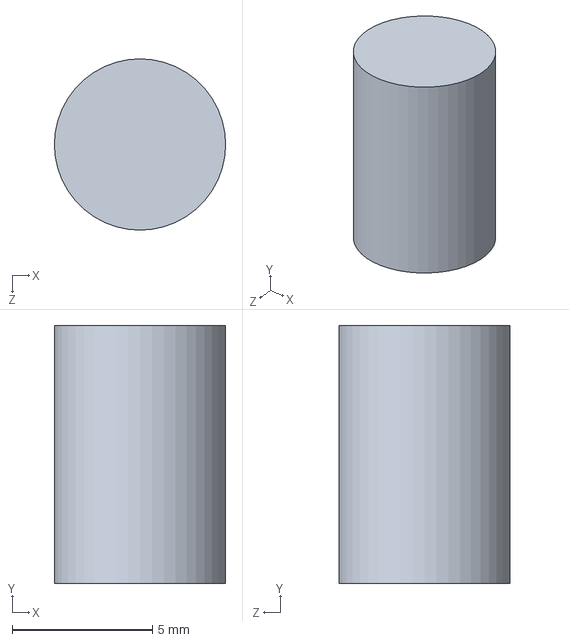
[picture p65: CAD file, 2014-09-19]
solidworks/misc/led.SLDPRT
6.10 x 9.19 x 6.10 mm
