texane/ooklone/solidworks/board/sma.SLDPRT

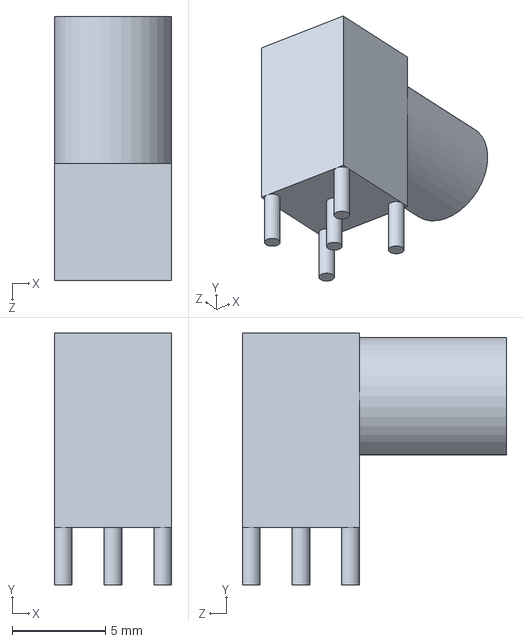
[picture p66: CAD file, 2014-09-15]
solidworks/board/sma.SLDPRT
6.30 x 13.5 x 14.2 mm
