texane/ooklone/solidworks/box/back_cm.STL

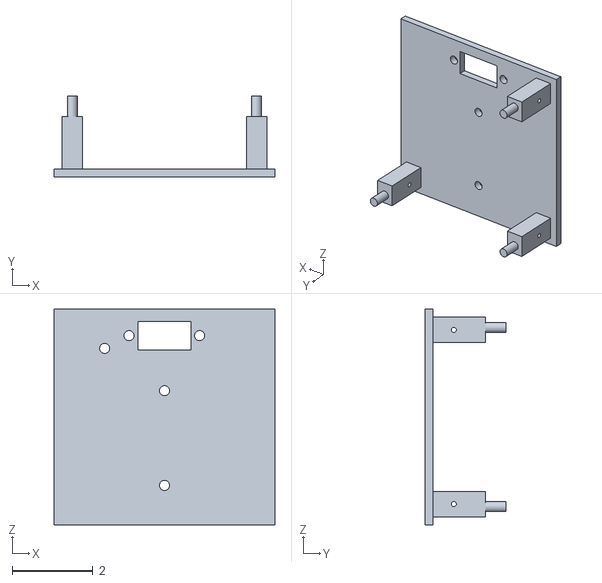
[picture p67: CAD file, 2014-09-21]
solidworks/box/back_cm.STL
5.48 x 2.00 x 5.35
