texane/ooklone/solidworks/misc/R13-509B-05-BB.SLDPRT

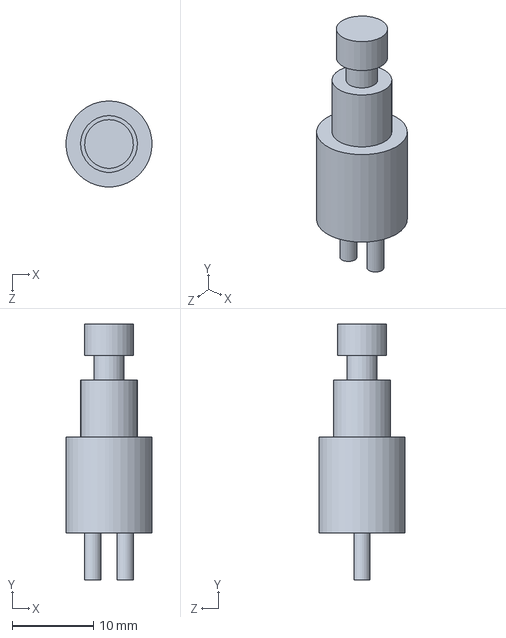
[picture p68: CAD file, 2014-09-19]
solidworks/misc/R13-509B-05-BB.SLDPRT
10.6 x 31.5 x 10.6 mm
