texane/ooklone/solidworks/misc/MFS106D.SLDPRT

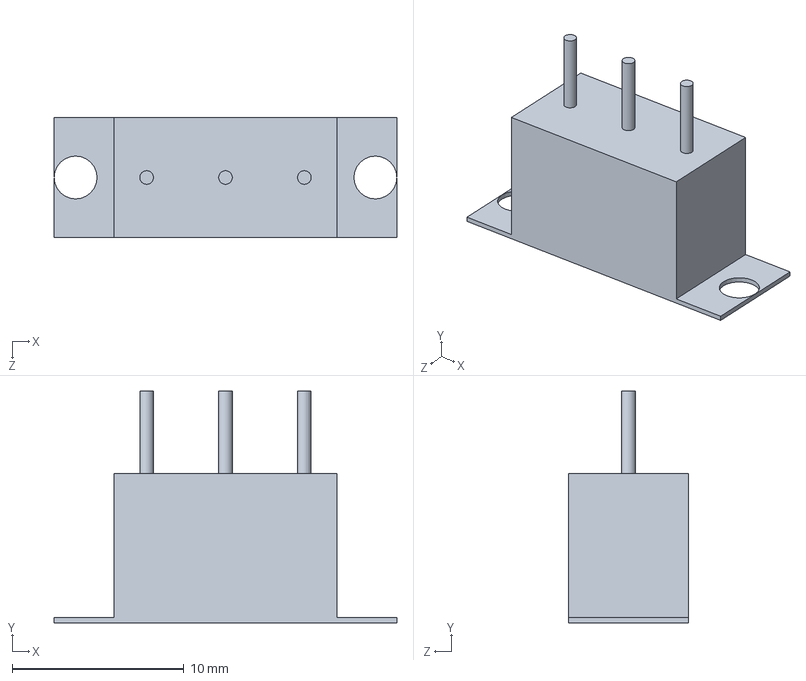
[picture p69: CAD file, 2014-09-19]
solidworks/misc/MFS106D.SLDPRT
20.0 x 13.5 x 7.00 mm
