texane/ooklone/solidworks/misc/sr2611.SLDPRT

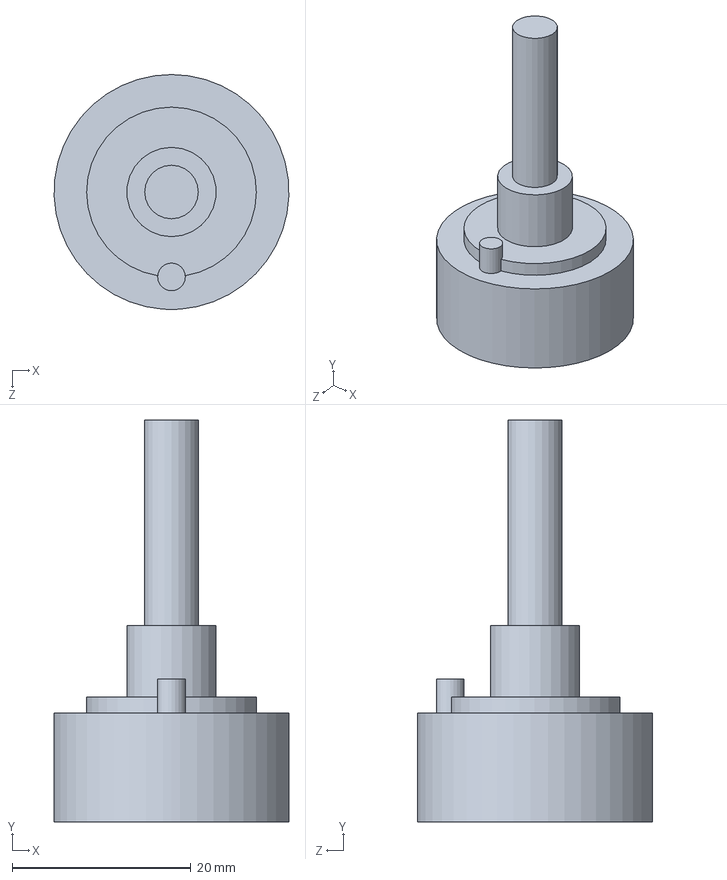
[picture p70: CAD file, 2014-09-18]
solidworks/misc/sr2611.SLDPRT
26.3 x 45.0 x 26.3 mm
