texane/ooklone/solidworks/box/front_cm.STL

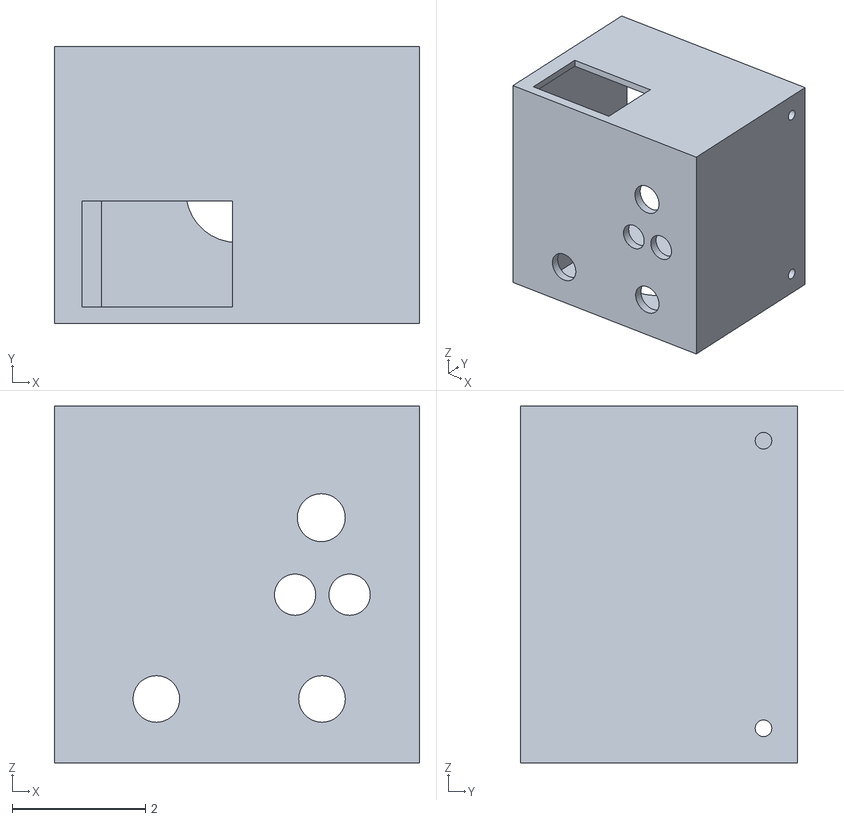
[picture p71: CAD file, 2014-09-21]
solidworks/box/front_cm.STL
5.48 x 4.16 x 5.35
