texane/ooklone/(list of files, cad)

Other CAD files:
solidworks/box/back_mm.STL
solidworks/box/front_mm.STL
solidworks/misc/screw_m2.5.SLDPRT
