texane/ooklone/sch/main.pdf

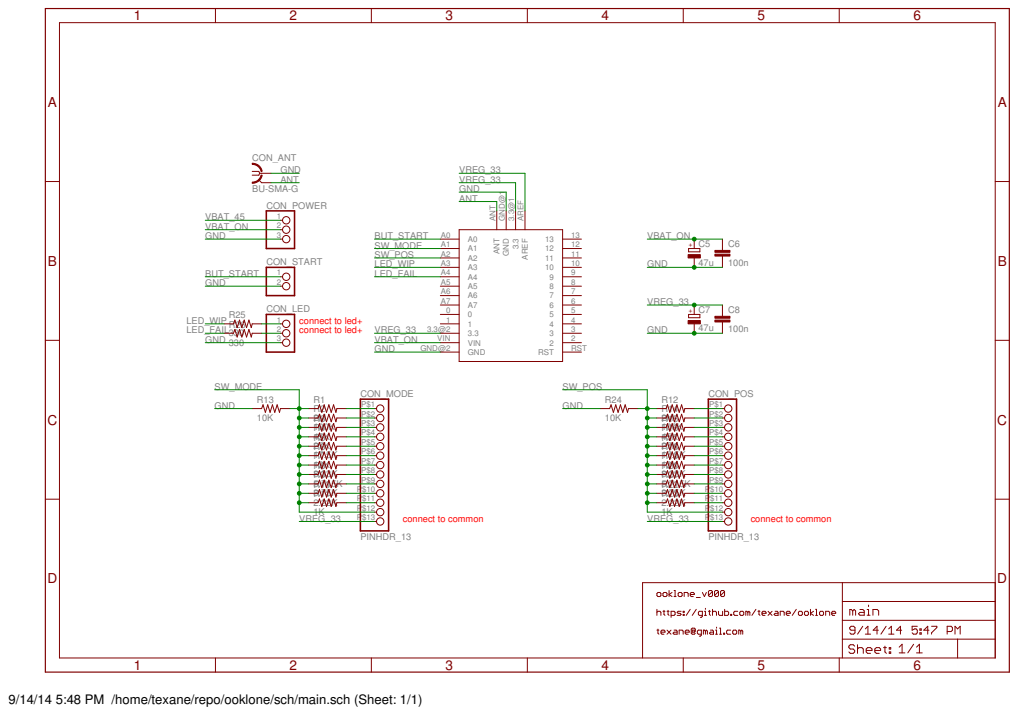
[picture p72: page 1]

9/14/14 5:48 PM /home/texane/repo/ooklone/sch/main.sch (Sheet: 1/1)
