texane/ooklone/sch/main.brd

## EAGLE design sch/main.brd (2014-10-11)

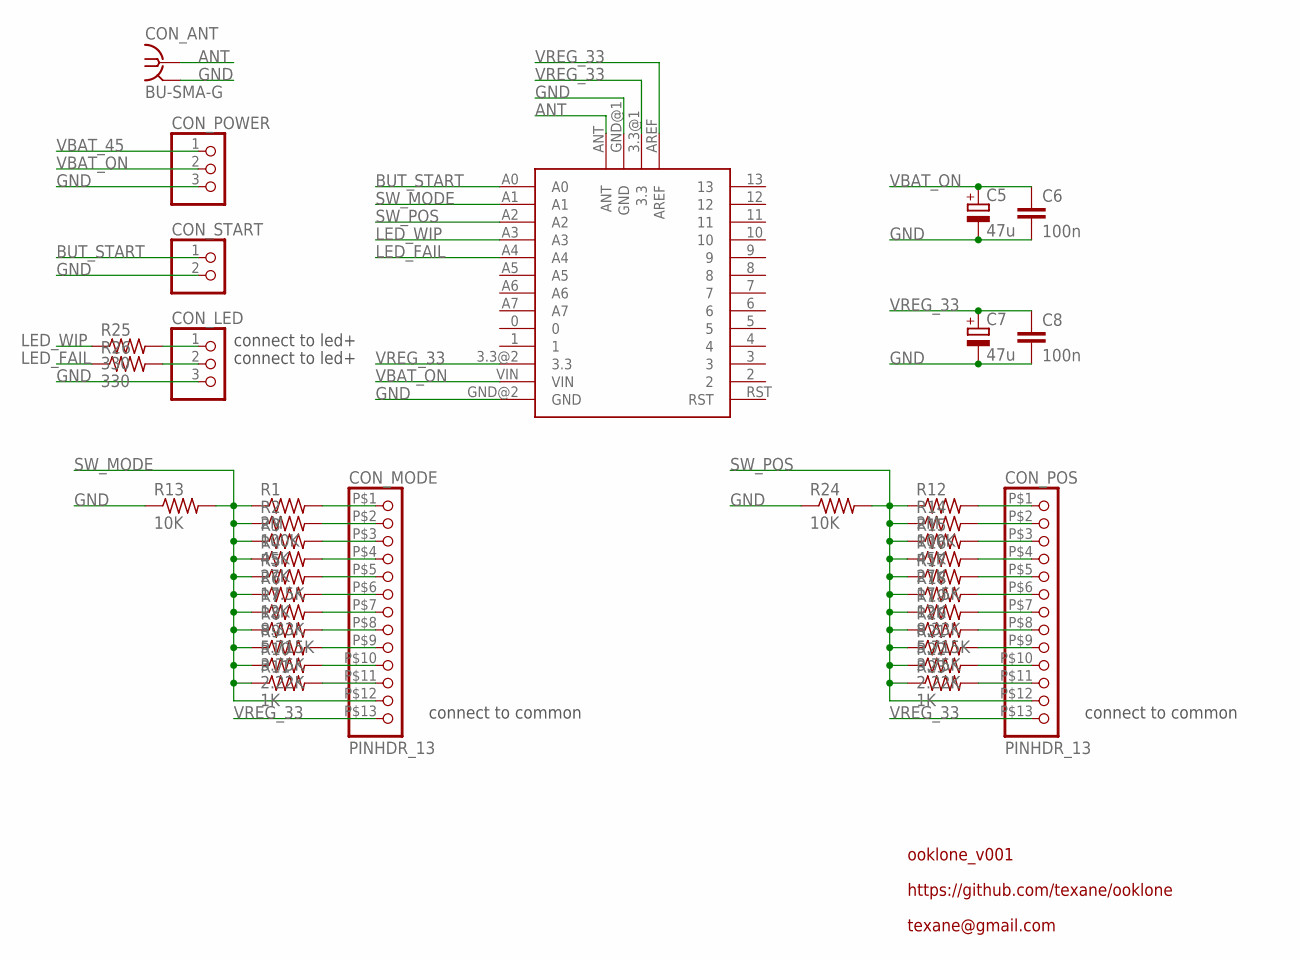
[picture p73: schematic main.sch]

Parts:
C5, C7: 47u; PANASONIC_D
C6, C8: 100n; C1206K
CON_ANT: BU-SMA-G
CON_LED: PINHD-1X3; 1X03
CON_MODE: PINHDR_13
CON_POS: PINHDR_13
CON_POWER: PINHD-1X3; 1X03
CON_START: PINHD-1X2; 1X02
R1, R12: 2M; R1206
R2, R14: 100K; R1206
R3, R15: 45K; R1206
R4, R16: 27K; R1206
R5, R17: 17.5K; R1206
R6, R18: 12K; R1206
R7, R19: 8.33K; R1206
R8, R20: 5.715K; R1206
R9, R21: 3.75K; R1206
R10, R22: 2.22K; R1206
R11, R23: 1K; R1206
R13, R24: 10K; R1206
R25, R26: 330; R1206
U$1: MOTEINO_USB_R4

Connections:
ANT: CON_ANT.1, U$1.ANT
BUT_START: CON_START.1, U$1.A0
GND: C5.-, C6.2, C7.-, C8.2, CON_ANT.2, CON_ANT.3 (2), CON_ANT.4 (2), CON_ANT.5 (2), CON_LED.3, CON_POWER.3, CON_START.2, R13.1, R24.1, U$1.GND@1 (GND), U$1.GND@2 (GND)
LED_FAIL: R26.1, U$1.A4
LED_WIP: R25.1, U$1.A3
unnamed: CON_MODE.P$1 (1), R1.2
unnamed: CON_MODE.P$2 (2), R2.2
unnamed: CON_MODE.P$3 (3), R3.2
unnamed: CON_MODE.P$4 (4), R4.2
unnamed: CON_MODE.P$5 (5), R5.2
unnamed: CON_MODE.P$6 (6), R6.2
unnamed: CON_MODE.P$7 (7), R7.2
unnamed: CON_MODE.P$8 (8), R8.2
unnamed: CON_MODE.P$9 (9), R9.2
unnamed: CON_MODE.P$10 (10), R10.2
unnamed: CON_MODE.P$11 (11), R11.2
unnamed: CON_POS.P$1 (1), R12.2
unnamed: CON_POS.P$2 (2), R14.2
unnamed: CON_POS.P$3 (3), R15.2
unnamed: CON_POS.P$4 (4), R16.2
unnamed: CON_POS.P$5 (5), R17.2
unnamed: CON_POS.P$6 (6), R18.2
unnamed: CON_POS.P$7 (7), R19.2
unnamed: CON_POS.P$8 (8), R20.2
unnamed: CON_POS.P$9 (9), R21.2
unnamed: CON_POS.P$10 (10), R22.2
unnamed: CON_POS.P$11 (11), R23.2
unnamed: CON_LED.1, R25.2
unnamed: CON_LED.2, R26.2
SW_MODE: CON_MODE.P$12 (12), R1.1, R2.1, R3.1, R4.1, R5.1, R6.1, R7.1, R8.1, R9.1, R10.1, R11.1, R13.2, U$1.A1
SW_POS: CON_POS.P$12 (12), R12.1, R14.1, R15.1, R16.1, R17.1, R18.1, R19.1, R20.1, R21.1, R22.1, R23.1, R24.2, U$1.A2
VBAT_45: CON_POWER.1
VBAT_ON: C5.+, C6.1, CON_POWER.2, U$1.VIN
VREG_33: C7.+, C8.1, CON_MODE.P$13 (13), CON_POS.P$13 (13), U$1.3.3@1 (3.3), U$1.3.3@2 (3.3), U$1.AREF

Notes on the sheet:
connect to led+
connect to common
ooklone_v001
https://github.com/texane/ooklone
texane@gmail.com

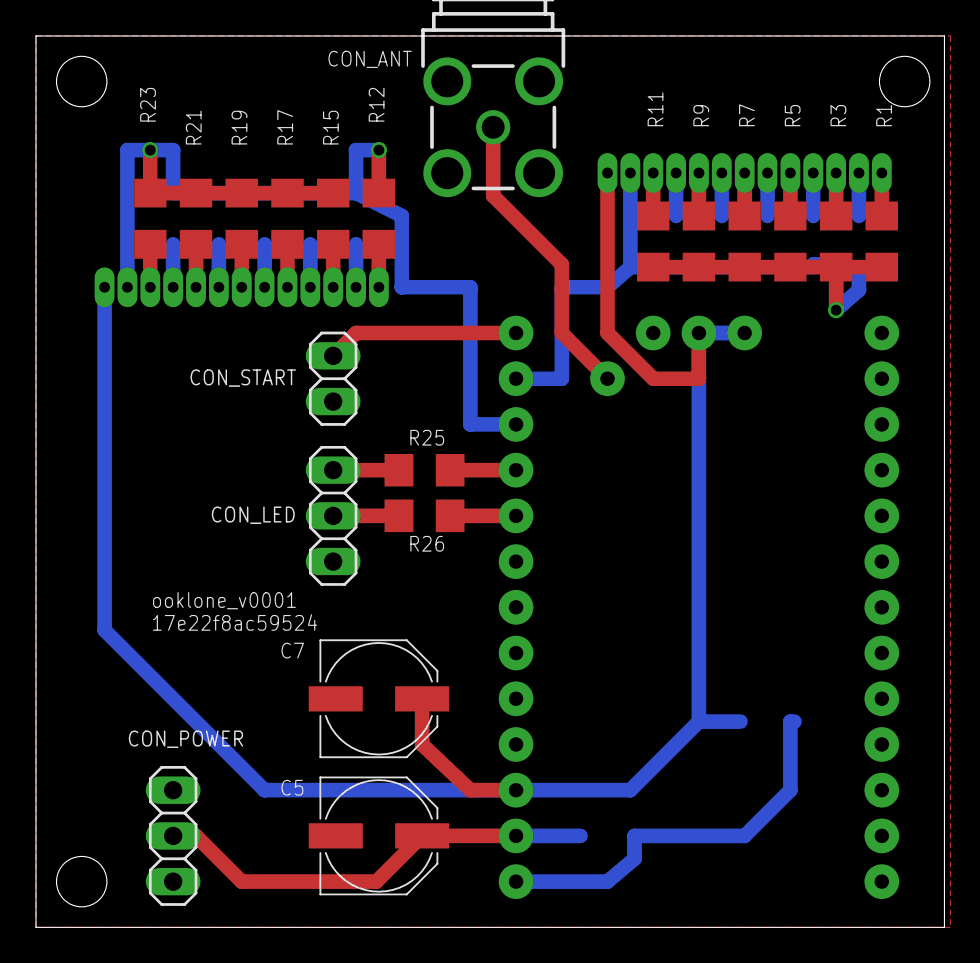
[picture p74: board main.brd from above]

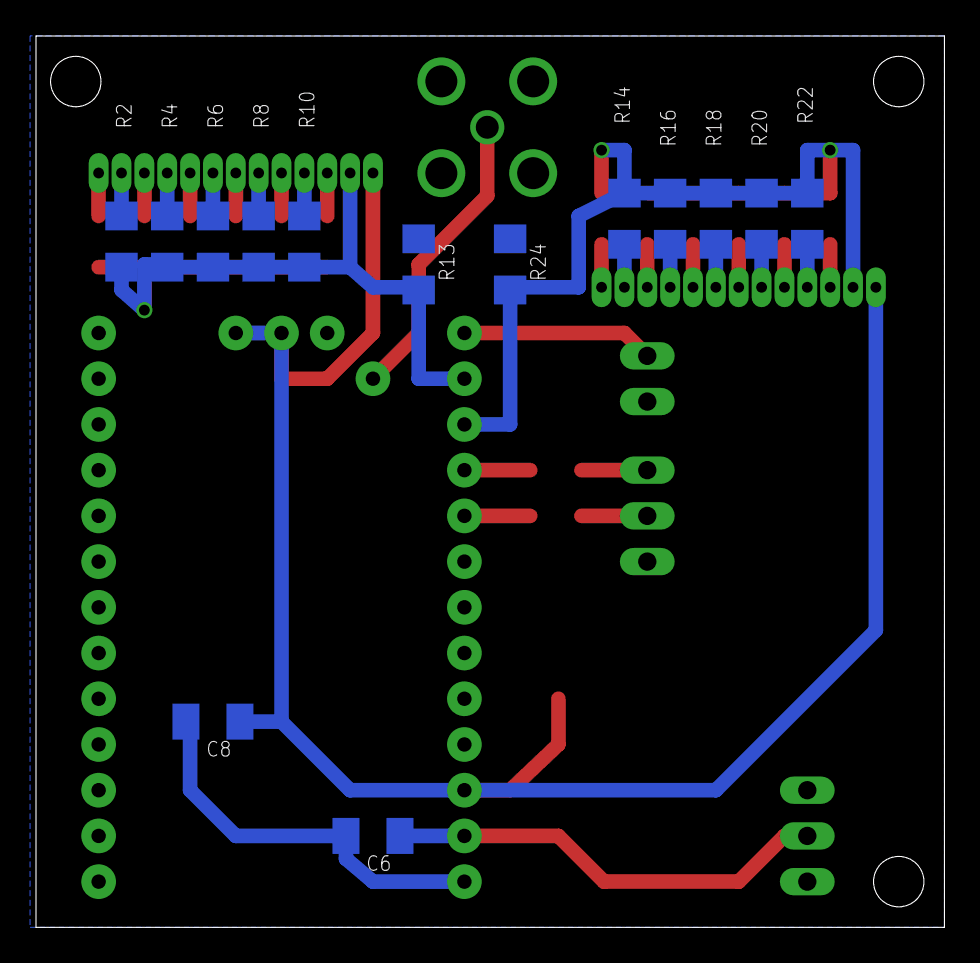
[picture p75: board main.brd from below]

Board: 2 copper layers, 50.5 x 49.5 mm, 37 parts (14 on the bottom side), 33 nets.
