texane/ooklone/(commit log)

2014-08-06 [ update ] continuous ook mode with fixed rssi threshold
    [main.c, rfm69.c]
2014-08-07 [ update ] ook peak versus fixed
    [main.c, rfm69.c]
2014-08-08 [ update ] pcint mode, pulse filtering
2014-08-12 [ update ] button support
2014-08-12 [ update ] sleep while waiting for button
2014-08-12 [ update ] no but_pcint_pins reset to handle continuous press
    [main.c]
2014-08-15 [ update ] rotary_switch resistor computation tool
2014-08-15 [ update ] rotary_switch resistor computation tool missing table
    [main.c]
2014-08-16 [ update ] rotary_switch tool, add actual resistor values
2014-08-16 [ update ] 7 position rotary switch added
2014-08-16 [ update ] clean rotary switch code
2014-08-16 [ update ] rotary switch notes
2014-08-16 [ update ] per frame slicer context
2014-08-17 [ update ] PULSE_MAX_TIMER fixed to 0xff, pulse_all_eofs
    [main.c]
2014-08-17 [ update, fix ] flash invalid subsector address computation, better unit test
    [flash.c]
2014-08-18 [ update ] use flash to store and load frames
2014-08-18 [ update ] UART_WRITE_STRING
2014-08-20 [ update ] doc/system_design missing ground
2014-08-28 [ add ] sch/main.bom
2014-08-28 [ add ] sch/main.sch
    [main.sch]
2014-08-28 [ update ] schematics, rotary switch util
    [main.sch]
2014-08-30 [ update ] schematics, bom
    [main.sch]
2014-09-13 [ add ] main.brd pinhdr_13.lbr
    [main.brd, main.sch]
2014-09-13 [ update ] schematics, routing
    [main.brd, main.sch]
2014-09-14 [ update ] todo, sma footprint ok
2014-09-14 [ update ] silkscreen cleaned
    [main.brd, main.sch]
2014-09-14 [ update ] schematics frame
    [main.sch]
2014-09-14 [ update ] add name and version on silkscreen
    [main.brd]
2014-09-14 [ update ] add name git commit on silkscreen
    [main.brd]
2014-09-15 [ add ] solidworks
    [board.SLDASM, cap.SLDPRT, moteino.SLDPRT, pcb.SLDPRT, sma.SLDPRT]
2014-09-18 [ add ] sr2611 1 pole 12 positions rotary switch
    [sr2611.SLDPRT]
2014-09-18 [ add ] battery holder, grayhill rotary switch
    [56SD30-01-1-AJN.SLDPRT, all.SLDASM, back.SLDPRT, battery_holder.SLDPRT, front.SLDPRT, sr2611.SLDPRT]
2014-09-18 [ update ] bom, on off switch and start button
    [all.SLDASM, back.SLDPRT]
2014-09-19 [ add ] MFS106D switch
    [MFS106D.SLDPRT, all.SLDASM]
2014-09-19 [ add ] R13-509B-05-BB.SLDPRT push button
    [R13-509B-05-BB.SLDPRT, all.SLDASM, battery_holder.SLDPRT, front.SLDPRT]
2014-09-19 [ update ] minor
    [all.SLDASM, back.SLDPRT]
2014-09-19 [ add ] led
    [all.SLDASM, front.SLDPRT, led.SLDPRT]
2014-09-19 [ add ] screw_m2.5
    [56SD30-01-1-AJN.SLDPRT, all.SLDASM, front.SLDPRT, screw_m2.5.SLDPRT]
2014-09-21 [ add ] enclosure STL
    [all.SLDASM, back.SLDPRT, back_cm.STL, back_mm.STL, battery_holder.SLDPRT, front.SLDPRT, front_cm.STL, front_mm.STL]
2014-09-22 [ add ] front,back_inches.STL
    [back_inches.STL, front_inches.STL]
2014-09-22 [ update ] main.bom
2014-10-11 [ fix ] gnd ant signal inversion
    [main.brd, main.sch]
2014-10-11 [ update ] schematics version, silkscreen
    [main.brd, main.sch]
2014-10-11 [ add ] pcb v0000 pictures
2014-10-16 [ add ] 3d printed enclosure pictures
